andreaslagler/giove8k/README.md

# giove8k
Giove 8k audio synthesizer project
