andreaslagler/giove8k/hw/AudioBoard/AudioBoard.kicad_pcb

## KiCad design hw/AudioBoard/AudioBoard.kicad_pcb (2022-02-02)

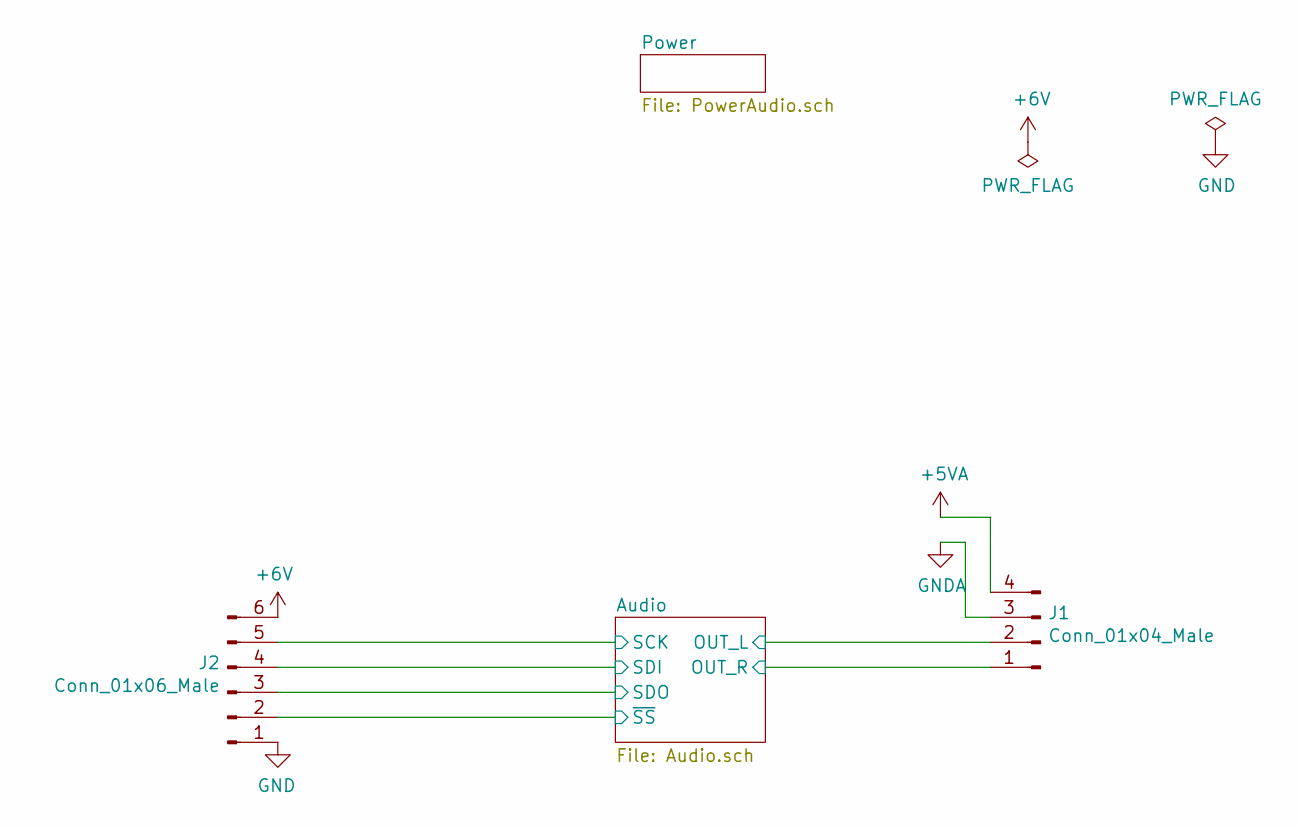
[picture p1: schematic AudioBoard.sch, Synth]

Parts:
J1: Conn_01x04_Male; PinHeader_1x04_P2.54mm_Vertical
J2: Conn_01x06_Male; PinHeader_1x06_P2.54mm_Vertical

Connections:
+5VA: J1.4; also elsewhere on the board
+6V: J2.6; also elsewhere on the board
/Audio/OUT_L: J1.2; also elsewhere on the board
/Audio/OUT_R: J1.1; also elsewhere on the board
/Audio/SCK: J2.5; also elsewhere on the board
/Audio/SDI: J2.4; also elsewhere on the board
/Audio/SDO: J2.3; also elsewhere on the board
/Audio/~SS: J2.2; also elsewhere on the board
GND: J1.3, J2.1; also elsewhere on the board

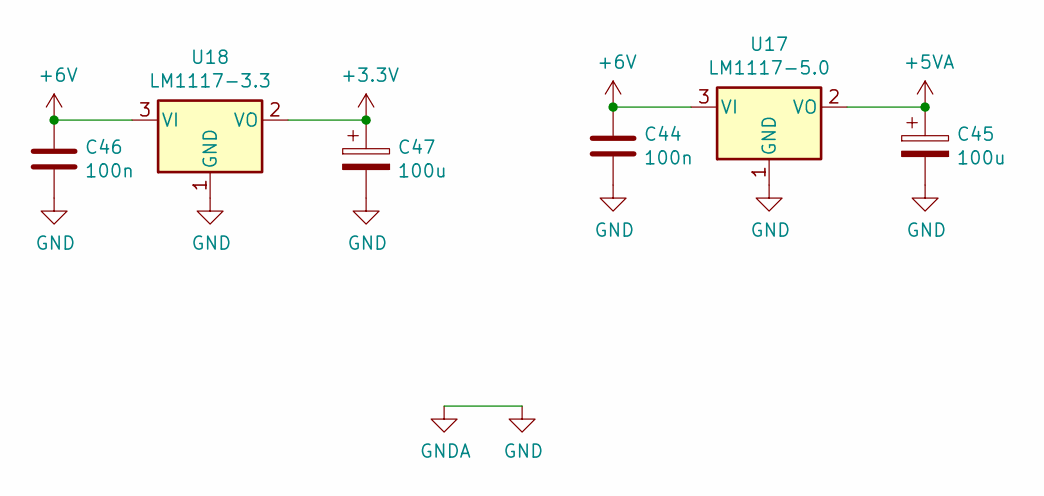
[picture p2: schematic PowerAudio.sch, Power (Controller)]

Parts:
C44, C46: 100n; C_Disc_D4.3mm_W1.9mm_P5.00mm
C45, C47: 100u; CP_Radial_D8.0mm_P5.00mm
U17: LM1117-5.0; TO-220F-3_Horizontal_TabDown
U18: LM1117-3.3; TO-220F-3_Horizontal_TabDown

Connections:
+3V3: C47.1, U18.2 (VO); also elsewhere on the board
+5VA: C45.1, U17.2 (VO); also elsewhere on the board
+6V: C44.1, C46.1, U17.3 (VI), U18.3 (VI); also elsewhere on the board
GND: C44.2, C45.2, C46.2, C47.2, U17.1 (GND), U18.1 (GND); also elsewhere on the board

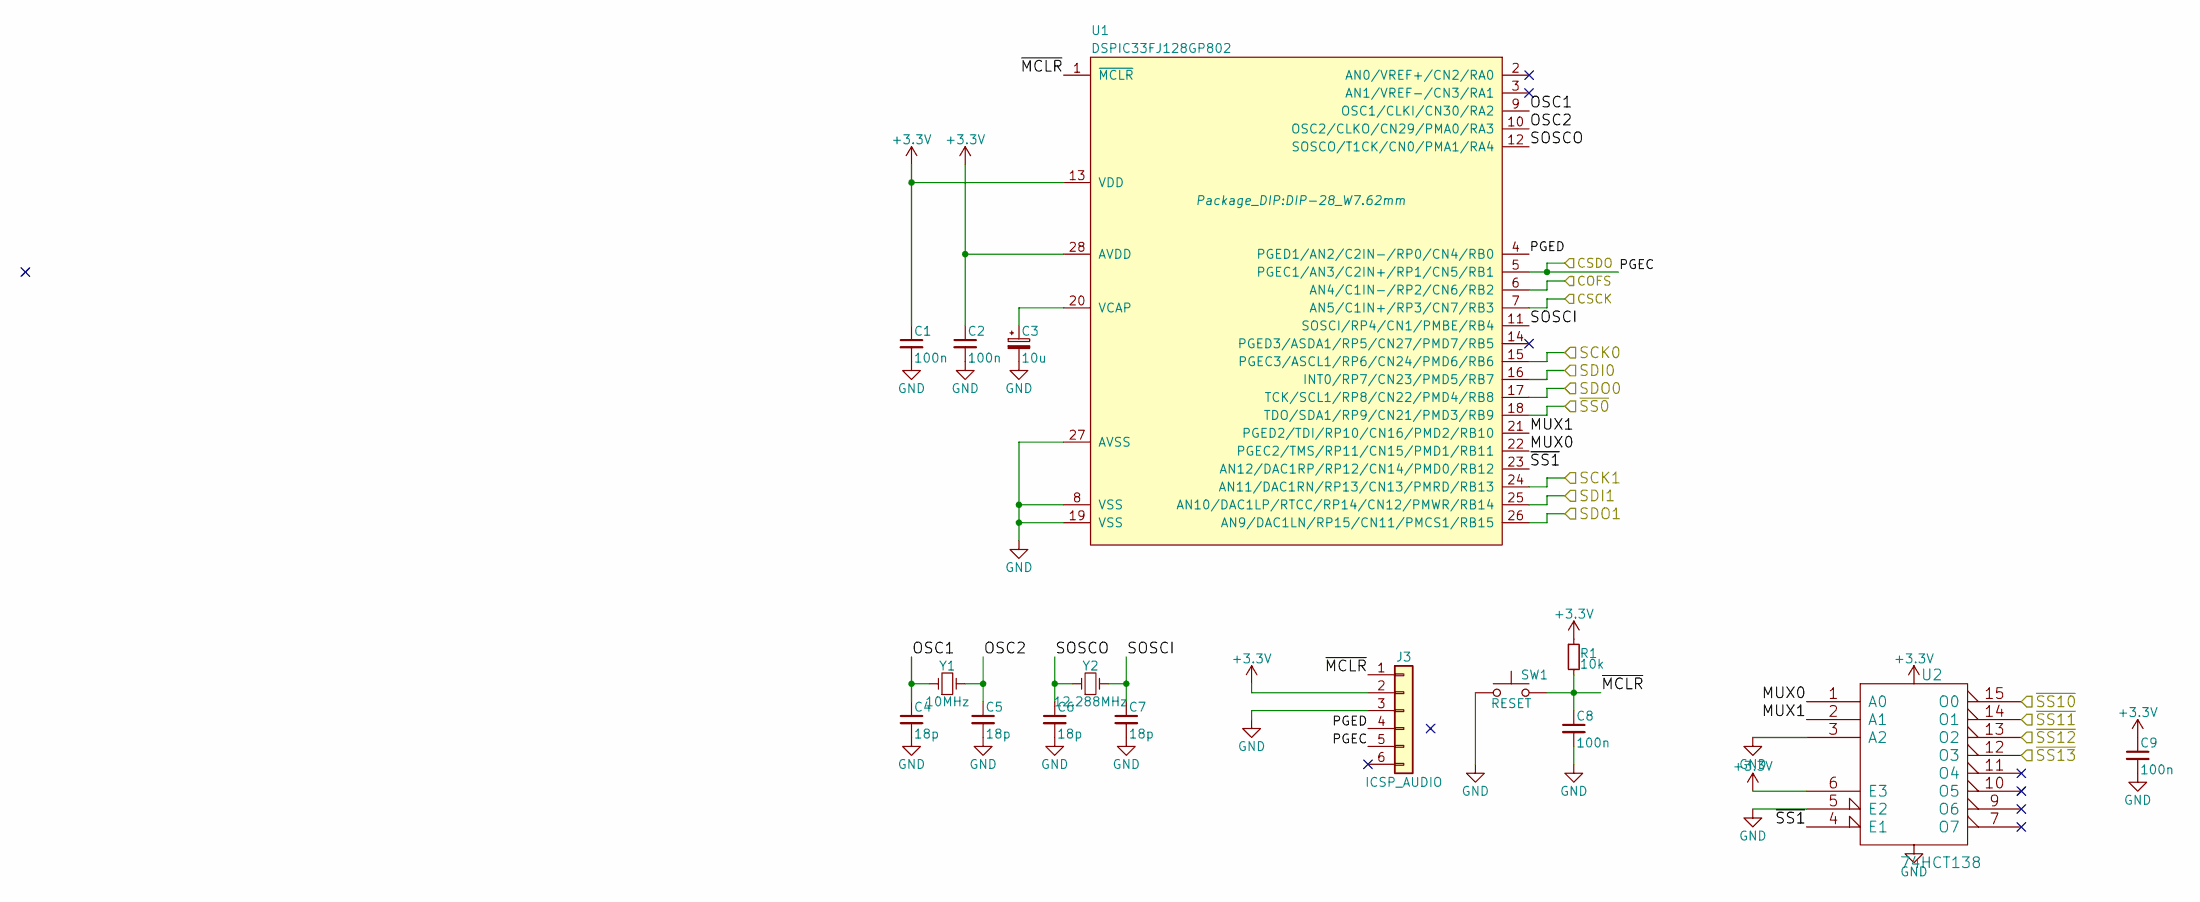
[picture p3: schematic DSP0.sch, Audio DSP]

Parts:
C1, C2, C8, C9: 100n; C_Disc_D4.3mm_W1.9mm_P5.00mm
C3: 10u; CP_Radial_D5.0mm_P2.50mm
C4, C5, C6, C7: 18p; C_Disc_D3.0mm_W1.6mm_P2.50mm
J3: ICSP_AUDIO; Molex_KK-254_AE-6410-06A_1x06_P2.54mm_Vertical
R1: 10k; R_Axial_DIN0207_L6.3mm_D2.5mm_P10.16mm_Horizontal
SW1: RESET; SW_PUSH_6mm
U1: DSPIC33FJ128GP802; DIP-28_W7.62mm
U2: 74HCT138; DIP-16_W7.62mm
Y1: 10MHz; Crystal_HC49-U_Vertical
Y2: 12.288MHz; Crystal_HC49-U_Vertical

Connections:
+3V3: C1.1, C2.1, C9.1, J3.2, R1.1, U1.13 (VDD), U1.28 (AVDD), U2.6 (E3), U2.16 (VCC); also elsewhere on the board
/Audio/COFS: U1.6 (AN4/C1IN-/RP2/CN6/RB2); also elsewhere on the board
/Audio/CSDO: J3.5, U1.5 (PGEC1/AN3/C2IN+/RP1/CN5/RB1); also elsewhere on the board
/Audio/CSK: U1.7 (AN5/C1IN+/RP3/CN7/RB3); also elsewhere on the board
/Audio/DSP0/MUX0: U1.22 (PGEC2/TMS/RP11/CN15/PMD1/RB11), U2.1 (A0)
/Audio/DSP0/MUX1: U1.21 (PGED2/TDI/RP10/CN16/PMD2/RB10), U2.2 (A1)
/Audio/DSP0/OSC1: C4.1, U1.9 (OSC1/CLKI/CN30/RA2), Y1.1
/Audio/DSP0/OSC2: C5.1, U1.10 (OSC2/CLKO/CN29/PMA0/RA3), Y1.2
/Audio/DSP0/PGED: J3.4, U1.4 (PGED1/AN2/C2IN-/RP0/CN4/RB0)
/Audio/DSP0/SOSCI: C7.1, U1.11 (SOSCI/RP4/CN1/PMBE/RB4), Y2.2
/Audio/DSP0/SOSCO: C6.1, U1.12 (SOSCO/T1CK/CN0/PMA1/RA4), Y2.1
/Audio/DSP0/~MCLR: C8.1, J3.1, R1.2, SW1.2, U1.1 (~MCLR)
/Audio/DSP0/~SS1: U1.23 (AN12/DAC1RP/RP12/CN14/PMD0/RB12), U2.4 (E1)
/Audio/SCK: U1.15 (PGEC3/ASCL1/RP6/CN24/PMD6/RB6); also elsewhere on the board
/Audio/SCK1: U1.24 (AN11/DAC1RN/RP13/CN13/PMRD/RB13); also elsewhere on the board
/Audio/SDI: U1.16 (INT0/RP7/CN23/PMD5/RB7); also elsewhere on the board
/Audio/SDI1: U1.25 (AN10/DAC1LP/RTCC/RP14/CN12/PMWR/RB14); also elsewhere on the board
/Audio/SDO: U1.17 (TCK/SCL1/RP8/CN22/PMD4/RB8); also elsewhere on the board
/Audio/SDO1: U1.26 (AN9/DAC1LN/RP15/CN11/PMCS1/RB15); also elsewhere on the board
/Audio/~SS: U1.18 (TDO/SDA1/RP9/CN21/PMD3/RB9); also elsewhere on the board
/Audio/~SS0: U2.15 (O0); also elsewhere on the board
/Audio/~SS1: U2.14 (O1); also elsewhere on the board
/Audio/~SS2: U2.13 (O2); also elsewhere on the board
/Audio/~SS3: U2.12 (O3); also elsewhere on the board
GND: C1.2, C2.2, C3.2, C4.2, C5.2, C6.2, C7.2, C8.2, C9.2, J3.3, SW1.1, U1.8 (VSS), U1.19 (VSS), U1.27 (AVSS), U2.3 (A2), U2.5 (E2), U2.8 (GND); also elsewhere on the board
unnamed: C3.1, U1.20 (VCAP)

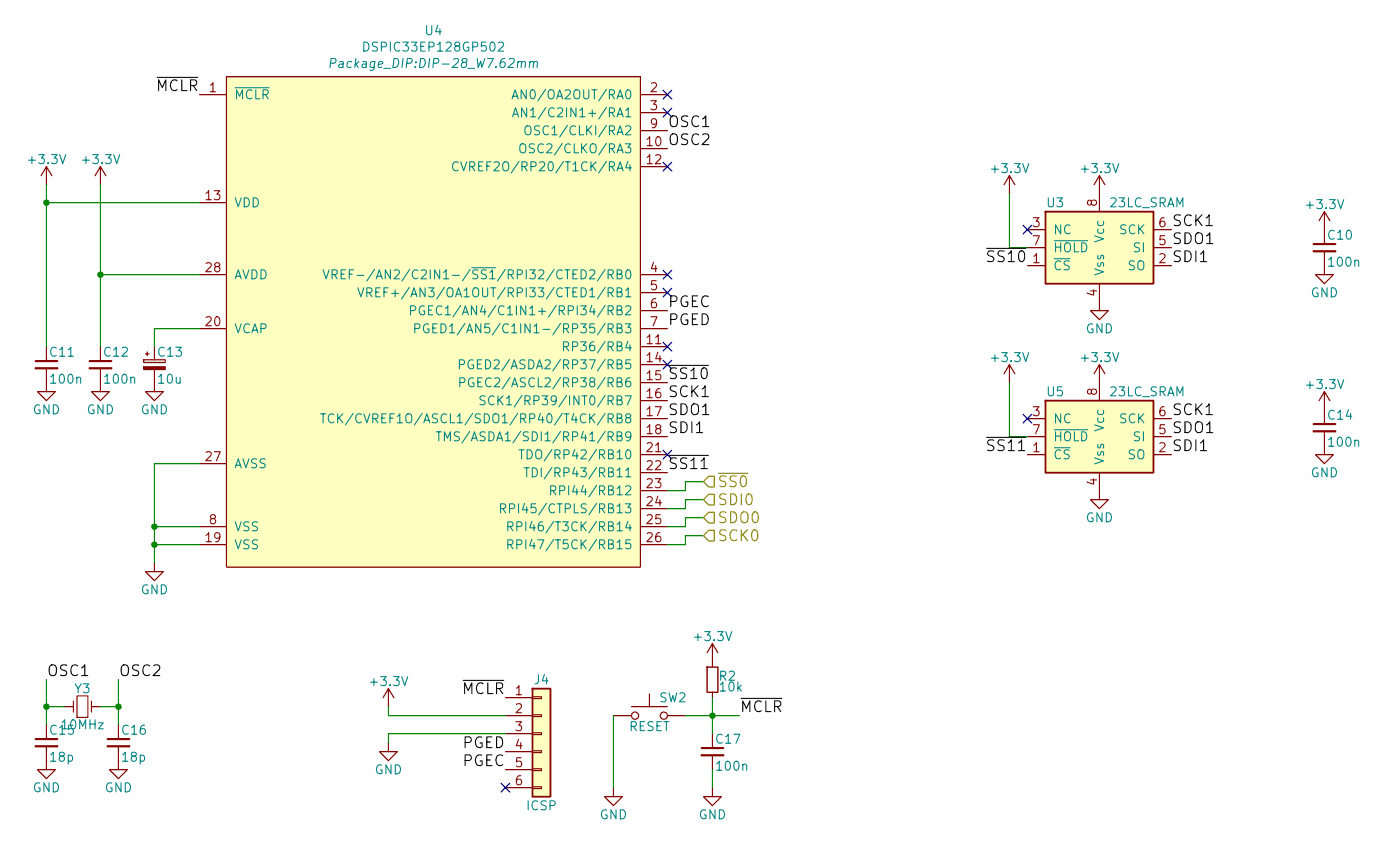
[picture p4: schematic DSP1.sch, DSP]

Parts:
C10, C11, C12, C14, C17: 100n; C_Disc_D4.3mm_W1.9mm_P5.00mm
C13: 10u; CP_Radial_D5.0mm_P2.50mm
C15, C16: 18p; C_Disc_D3.0mm_W1.6mm_P2.50mm
J4: ICSP; Molex_KK-254_AE-6410-06A_1x06_P2.54mm_Vertical
R2: 10k; R_Axial_DIN0207_L6.3mm_D2.5mm_P10.16mm_Horizontal
SW2: RESET; SW_PUSH_6mm
U3, U5: 23LC_SRAM; DIP-8_W7.62mm
U4: DSPIC33EP128GP502; DIP-28_W7.62mm
Y3: 10MHz; Crystal_HC49-U_Vertical

Connections:
+3V3: C10.1, C11.1, C12.1, C14.1, J4.2, R2.1, U3.7 (~HOLD), U3.8 (Vcc), U4.13 (VDD), U4.28 (AVDD), U5.7 (~HOLD), U5.8 (Vcc); also elsewhere on the board
/Audio/DSP1/OSC1: C15.1, U4.9 (OSC1/CLKI/RA2), Y3.1
/Audio/DSP1/OSC2: C16.1, U4.10 (OSC2/CLKO/RA3), Y3.2
/Audio/DSP1/PGEC: J4.5, U4.6 (PGEC1/AN4/C1IN1+/RPI34/RB2)
/Audio/DSP1/PGED: J4.4, U4.7 (PGED1/AN5/C1IN1-/RP35/RB3)
/Audio/DSP1/SCK1: U3.6 (SCK), U4.16 (SCK1/RP39/INT0/RB7), U5.6 (SCK)
/Audio/DSP1/SDI1: U3.2 (SO), U4.18 (TMS/ASDA1/SDI1/RP41/RB9), U5.2 (SO)
/Audio/DSP1/SDO1: U3.5 (SI), U4.17 (TCK/CVREF1O/ASCL1/SDO1/RP40/T4CK/RB8), U5.5 (SI)
/Audio/DSP1/~MCLR: C17.1, J4.1, R2.2, SW2.2, U4.1 (~MCLR)
/Audio/DSP1/~SS10: U3.1 (~CS), U4.15 (PGEC2/ASCL2/RP38/RB6)
/Audio/DSP1/~SS11: U4.22 (TDI/RP43/RB11), U5.1 (~CS)
/Audio/SCK1: U4.26 (RPI47/T5CK/RB15); also elsewhere on the board
/Audio/SDI1: U4.25 (RPI46/T3CK/RB14); also elsewhere on the board
/Audio/SDO1: U4.24 (RPI45/CTPLS/RB13); also elsewhere on the board
/Audio/~SS0: U4.23 (RPI44/RB12); also elsewhere on the board
GND: C10.2, C11.2, C12.2, C13.2, C14.2, C15.2, C16.2, C17.2, J4.3, SW2.1, U3.4 (Vss), U4.8 (VSS), U4.19 (VSS), U4.27 (AVSS), U5.4 (Vss); also elsewhere on the board
unnamed: C13.1, U4.20 (VCAP)

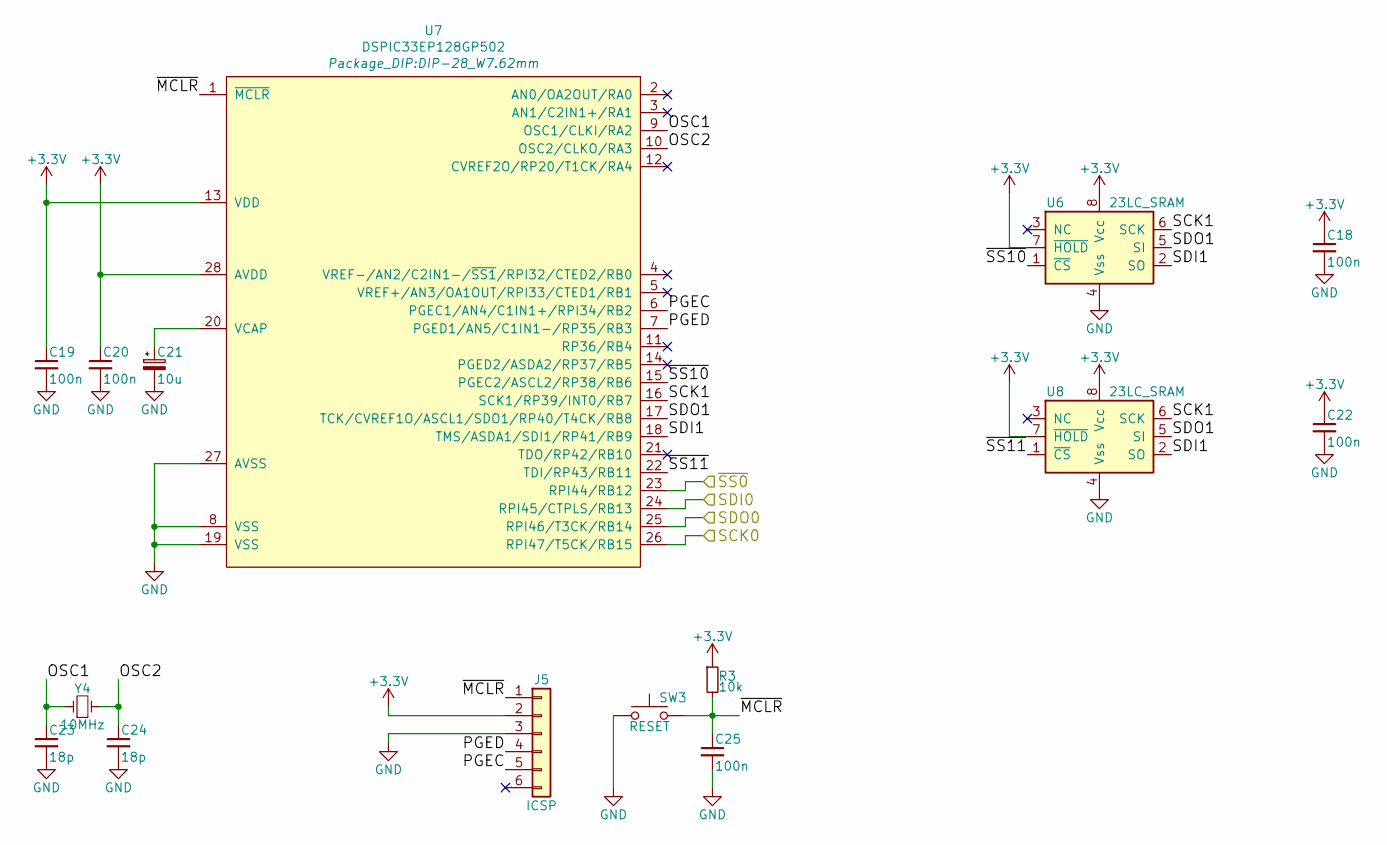
[picture p5: schematic DSP4.sch, DSP]

Parts:
C18, C19, C20, C22, C25: 100n; C_Disc_D4.3mm_W1.9mm_P5.00mm
C21: 10u; CP_Radial_D5.0mm_P2.50mm
C23, C24: 18p; C_Disc_D3.0mm_W1.6mm_P2.50mm
J5: ICSP; Molex_KK-254_AE-6410-06A_1x06_P2.54mm_Vertical
R3: 10k; R_Axial_DIN0207_L6.3mm_D2.5mm_P10.16mm_Horizontal
SW3: RESET; SW_PUSH_6mm
U6, U8: 23LC_SRAM; DIP-8_W7.62mm
U7: DSPIC33EP128GP502; DIP-28_W7.62mm
Y4: 10MHz; Crystal_HC49-U_Vertical

Connections:
+3V3: C18.1, C19.1, C20.1, C22.1, J5.2, R3.1, U6.7 (~HOLD), U6.8 (Vcc), U7.13 (VDD), U7.28 (AVDD), U8.7 (~HOLD), U8.8 (Vcc); also elsewhere on the board
/Audio/DSP4/OSC1: C23.1, U7.9 (OSC1/CLKI/RA2), Y4.1
/Audio/DSP4/OSC2: C24.1, U7.10 (OSC2/CLKO/RA3), Y4.2
/Audio/DSP4/PGEC: J5.5, U7.6 (PGEC1/AN4/C1IN1+/RPI34/RB2)
/Audio/DSP4/PGED: J5.4, U7.7 (PGED1/AN5/C1IN1-/RP35/RB3)
/Audio/DSP4/SCK1: U6.6 (SCK), U7.16 (SCK1/RP39/INT0/RB7), U8.6 (SCK)
/Audio/DSP4/SDI1: U6.2 (SO), U7.18 (TMS/ASDA1/SDI1/RP41/RB9), U8.2 (SO)
/Audio/DSP4/SDO1: U6.5 (SI), U7.17 (TCK/CVREF1O/ASCL1/SDO1/RP40/T4CK/RB8), U8.5 (SI)
/Audio/DSP4/~MCLR: C25.1, J5.1, R3.2, SW3.2, U7.1 (~MCLR)
/Audio/DSP4/~SS10: U6.1 (~CS), U7.15 (PGEC2/ASCL2/RP38/RB6)
/Audio/DSP4/~SS11: U7.22 (TDI/RP43/RB11), U8.1 (~CS)
/Audio/SCK1: U7.26 (RPI47/T5CK/RB15); also elsewhere on the board
/Audio/SDI1: U7.25 (RPI46/T3CK/RB14); also elsewhere on the board
/Audio/SDO1: U7.24 (RPI45/CTPLS/RB13); also elsewhere on the board
/Audio/~SS3: U7.23 (RPI44/RB12); also elsewhere on the board
GND: C18.2, C19.2, C20.2, C21.2, C22.2, C23.2, C24.2, C25.2, J5.3, SW3.1, U6.4 (Vss), U7.8 (VSS), U7.19 (VSS), U7.27 (AVSS), U8.4 (Vss); also elsewhere on the board
unnamed: C21.1, U7.20 (VCAP)

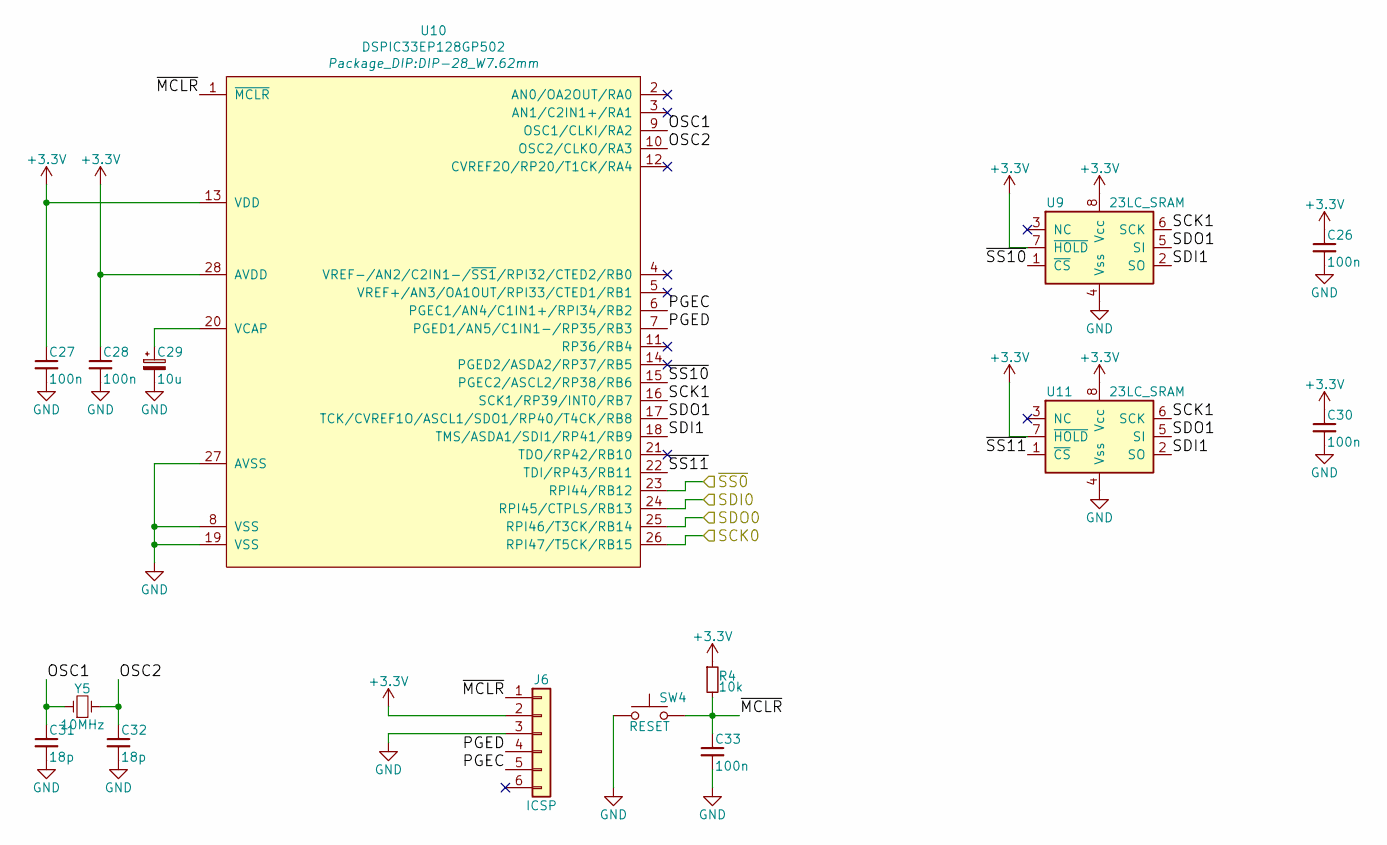
[picture p6: schematic DSP3.sch, DSP]

Parts:
C26, C27, C28, C30, C33: 100n; C_Disc_D4.3mm_W1.9mm_P5.00mm
C29: 10u; CP_Radial_D5.0mm_P2.50mm
C31, C32: 18p; C_Disc_D3.0mm_W1.6mm_P2.50mm
J6: ICSP; Molex_KK-254_AE-6410-06A_1x06_P2.54mm_Vertical
R4: 10k; R_Axial_DIN0207_L6.3mm_D2.5mm_P10.16mm_Horizontal
SW4: RESET; SW_PUSH_6mm
U9, U11: 23LC_SRAM; DIP-8_W7.62mm
U10: DSPIC33EP128GP502; DIP-28_W7.62mm
Y5: 10MHz; Crystal_HC49-U_Vertical

Connections:
+3V3: C26.1, C27.1, C28.1, C30.1, J6.2, R4.1, U9.7 (~HOLD), U9.8 (Vcc), U10.13 (VDD), U10.28 (AVDD), U11.7 (~HOLD), U11.8 (Vcc); also elsewhere on the board
/Audio/DSP3/OSC1: C31.1, U10.9 (OSC1/CLKI/RA2), Y5.1
/Audio/DSP3/OSC2: C32.1, U10.10 (OSC2/CLKO/RA3), Y5.2
/Audio/DSP3/PGEC: J6.5, U10.6 (PGEC1/AN4/C1IN1+/RPI34/RB2)
/Audio/DSP3/PGED: J6.4, U10.7 (PGED1/AN5/C1IN1-/RP35/RB3)
/Audio/DSP3/SCK1: U9.6 (SCK), U10.16 (SCK1/RP39/INT0/RB7), U11.6 (SCK)
/Audio/DSP3/SDI1: U9.2 (SO), U10.18 (TMS/ASDA1/SDI1/RP41/RB9), U11.2 (SO)
/Audio/DSP3/SDO1: U9.5 (SI), U10.17 (TCK/CVREF1O/ASCL1/SDO1/RP40/T4CK/RB8), U11.5 (SI)
/Audio/DSP3/~MCLR: C33.1, J6.1, R4.2, SW4.2, U10.1 (~MCLR)
/Audio/DSP3/~SS10: U9.1 (~CS), U10.15 (PGEC2/ASCL2/RP38/RB6)
/Audio/DSP3/~SS11: U10.22 (TDI/RP43/RB11), U11.1 (~CS)
/Audio/SCK1: U10.26 (RPI47/T5CK/RB15); also elsewhere on the board
/Audio/SDI1: U10.25 (RPI46/T3CK/RB14); also elsewhere on the board
/Audio/SDO1: U10.24 (RPI45/CTPLS/RB13); also elsewhere on the board
/Audio/~SS2: U10.23 (RPI44/RB12); also elsewhere on the board
GND: C26.2, C27.2, C28.2, C29.2, C30.2, C31.2, C32.2, C33.2, J6.3, SW4.1, U9.4 (Vss), U10.8 (VSS), U10.19 (VSS), U10.27 (AVSS), U11.4 (Vss); also elsewhere on the board
unnamed: C29.1, U10.20 (VCAP)

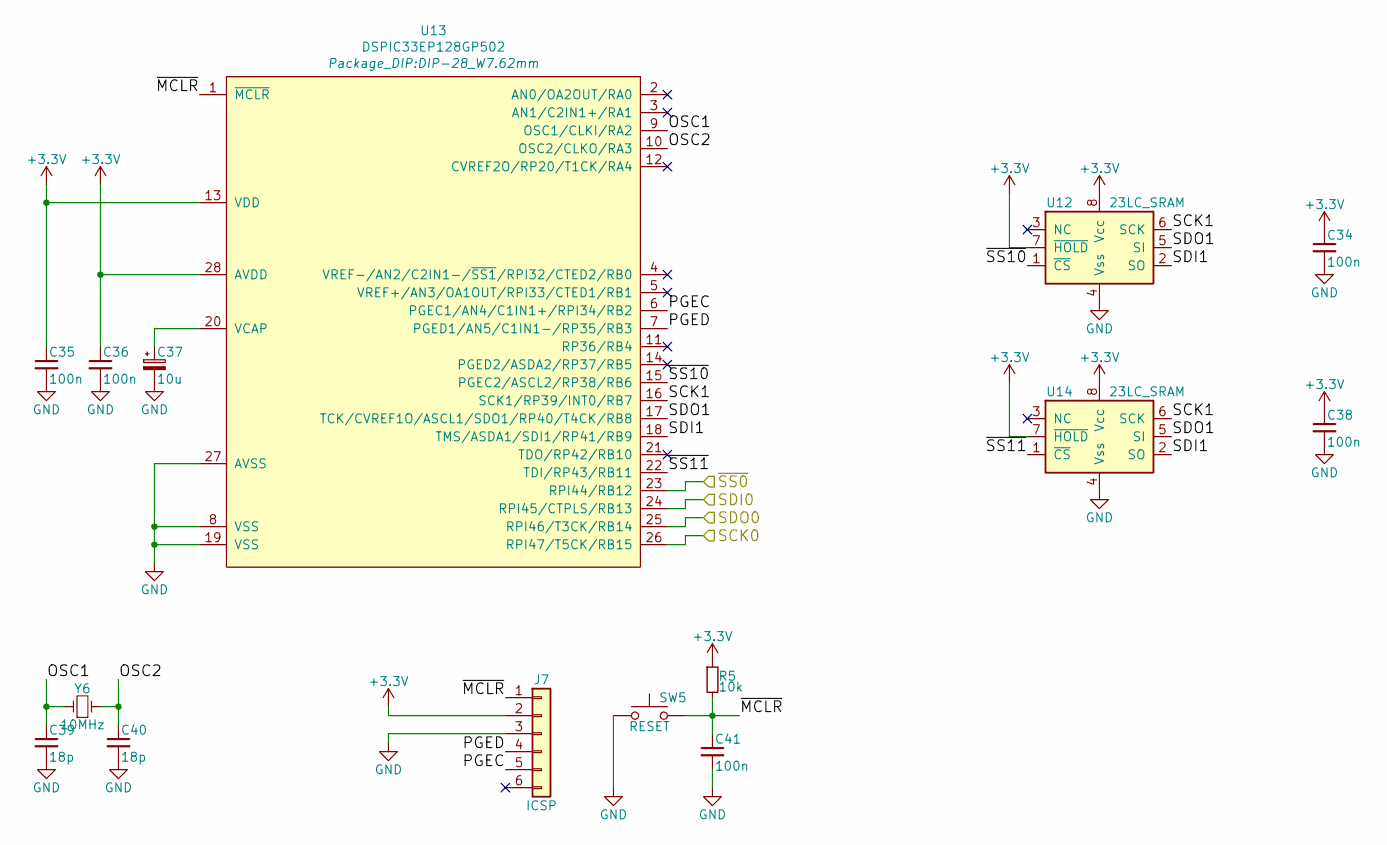
[picture p7: schematic DSP2.sch, DSP]

Parts:
C34, C35, C36, C38, C41: 100n; C_Disc_D4.3mm_W1.9mm_P5.00mm
C37: 10u; CP_Radial_D5.0mm_P2.50mm
C39, C40: 18p; C_Disc_D3.0mm_W1.6mm_P2.50mm
J7: ICSP; Molex_KK-254_AE-6410-06A_1x06_P2.54mm_Vertical
R5: 10k; R_Axial_DIN0207_L6.3mm_D2.5mm_P10.16mm_Horizontal
SW5: RESET; SW_PUSH_6mm
U12, U14: 23LC_SRAM; DIP-8_W7.62mm
U13: DSPIC33EP128GP502; DIP-28_W7.62mm
Y6: 10MHz; Crystal_HC49-U_Vertical

Connections:
+3V3: C34.1, C35.1, C36.1, C38.1, J7.2, R5.1, U12.7 (~HOLD), U12.8 (Vcc), U13.13 (VDD), U13.28 (AVDD), U14.7 (~HOLD), U14.8 (Vcc); also elsewhere on the board
/Audio/DSP2/OSC1: C39.1, U13.9 (OSC1/CLKI/RA2), Y6.1
/Audio/DSP2/OSC2: C40.1, U13.10 (OSC2/CLKO/RA3), Y6.2
/Audio/DSP2/PGEC: J7.5, U13.6 (PGEC1/AN4/C1IN1+/RPI34/RB2)
/Audio/DSP2/PGED: J7.4, U13.7 (PGED1/AN5/C1IN1-/RP35/RB3)
/Audio/DSP2/SCK1: U12.6 (SCK), U13.16 (SCK1/RP39/INT0/RB7), U14.6 (SCK)
/Audio/DSP2/SDI1: U12.2 (SO), U13.18 (TMS/ASDA1/SDI1/RP41/RB9), U14.2 (SO)
/Audio/DSP2/SDO1: U12.5 (SI), U13.17 (TCK/CVREF1O/ASCL1/SDO1/RP40/T4CK/RB8), U14.5 (SI)
/Audio/DSP2/~MCLR: C41.1, J7.1, R5.2, SW5.2, U13.1 (~MCLR)
/Audio/DSP2/~SS10: U12.1 (~CS), U13.15 (PGEC2/ASCL2/RP38/RB6)
/Audio/DSP2/~SS11: U13.22 (TDI/RP43/RB11), U14.1 (~CS)
/Audio/SCK1: U13.26 (RPI47/T5CK/RB15); also elsewhere on the board
/Audio/SDI1: U13.25 (RPI46/T3CK/RB14); also elsewhere on the board
/Audio/SDO1: U13.24 (RPI45/CTPLS/RB13); also elsewhere on the board
/Audio/~SS1: U13.23 (RPI44/RB12); also elsewhere on the board
GND: C34.2, C35.2, C36.2, C37.2, C38.2, C39.2, C40.2, C41.2, J7.3, SW5.1, U12.4 (Vss), U13.8 (VSS), U13.19 (VSS), U13.27 (AVSS), U14.4 (Vss); also elsewhere on the board
unnamed: C37.1, U13.20 (VCAP)

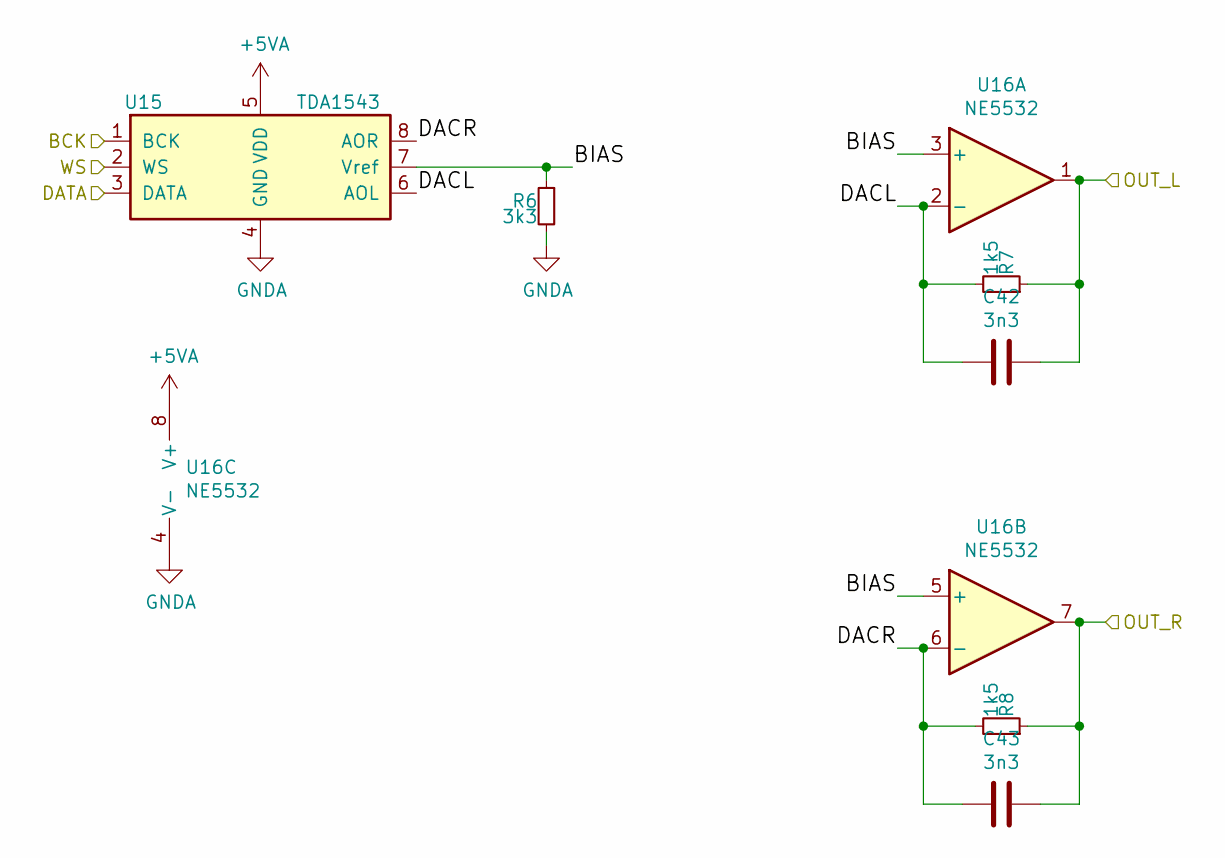
[picture p8: schematic DAC.sch]

Parts:
C42, C43: 3n3; C_Disc_D4.3mm_W1.9mm_P5.00mm
R6: 3k3; R_Axial_DIN0207_L6.3mm_D2.5mm_P10.16mm_Horizontal
R7, R8: 1k5; R_Axial_DIN0207_L6.3mm_D2.5mm_P10.16mm_Horizontal
U15: TDA1543; DIP-8_W7.62mm
U16: NE5532; DIP-8_W7.62mm

Connections:
+5VA: U15.5 (VDD), U16.8 (V+); also elsewhere on the board
/Audio/COFS: U15.2 (WS); also elsewhere on the board
/Audio/CSDO: U15.3 (DATA); also elsewhere on the board
/Audio/CSK: U15.1 (BCK); also elsewhere on the board
/Audio/DAC/BIAS: R6.1, U15.7 (Vref), U16.3 (+), U16.5 (+)
/Audio/DAC/DACL: C42.2, R7.2, U15.6 (AOL), U16.2 (-)
/Audio/DAC/DACR: C43.2, R8.2, U15.8 (AOR), U16.6 (-)
/Audio/OUT_L: C42.1, R7.1, U16.1; also elsewhere on the board
/Audio/OUT_R: C43.1, R8.1, U16.7; also elsewhere on the board
GND: R6.2, U15.4 (GND), U16.4 (V-); also elsewhere on the board

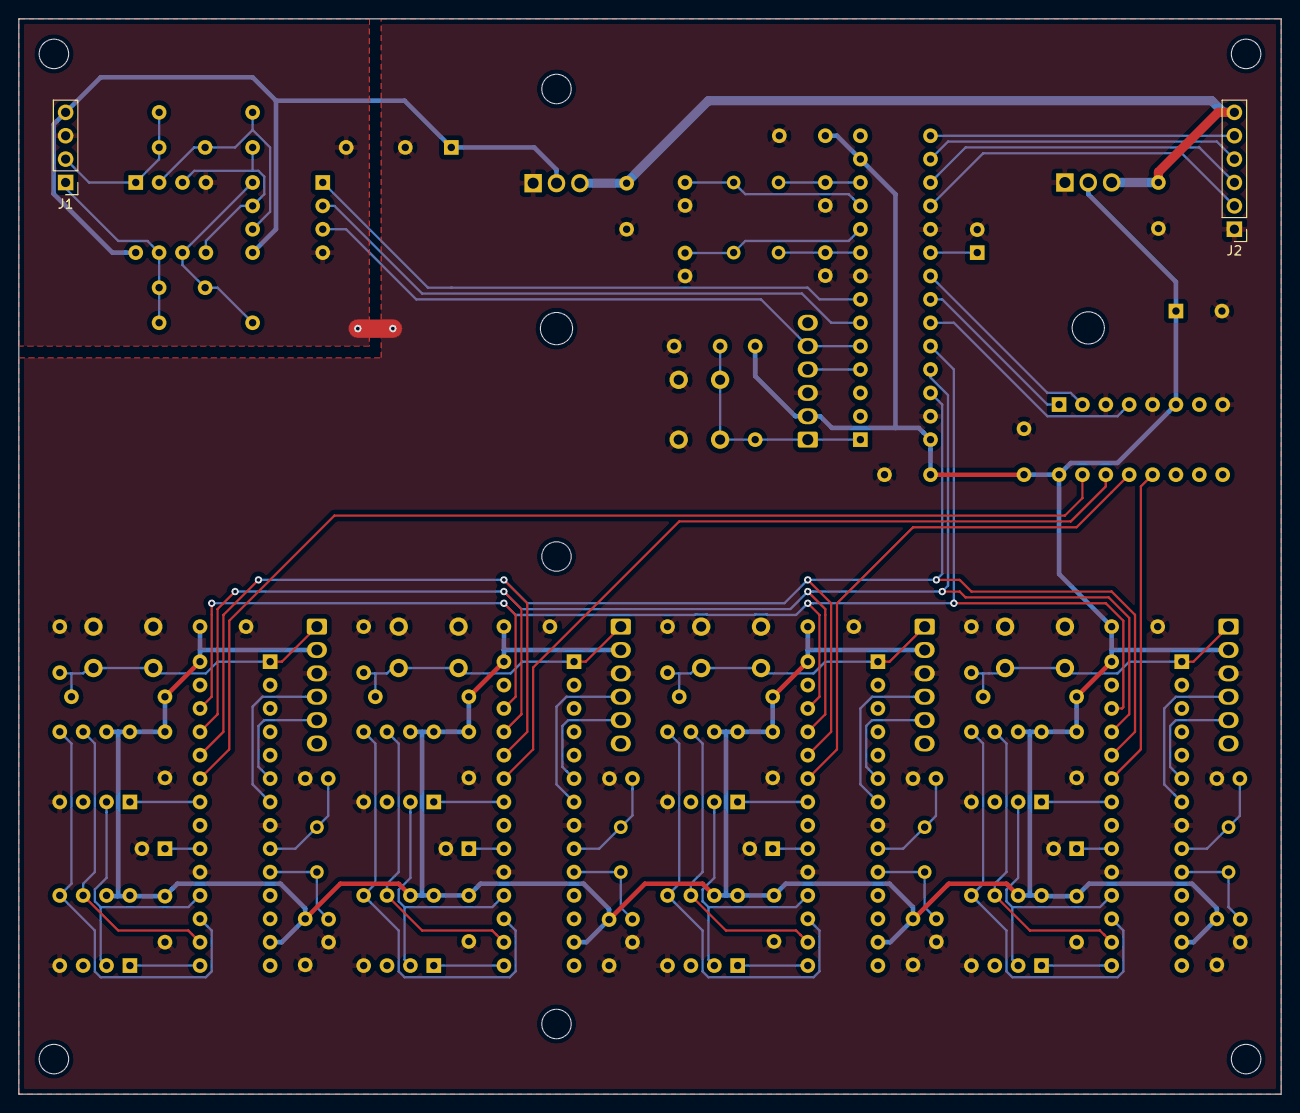
[picture p9: board AudioBoard.kicad_pcb from above]

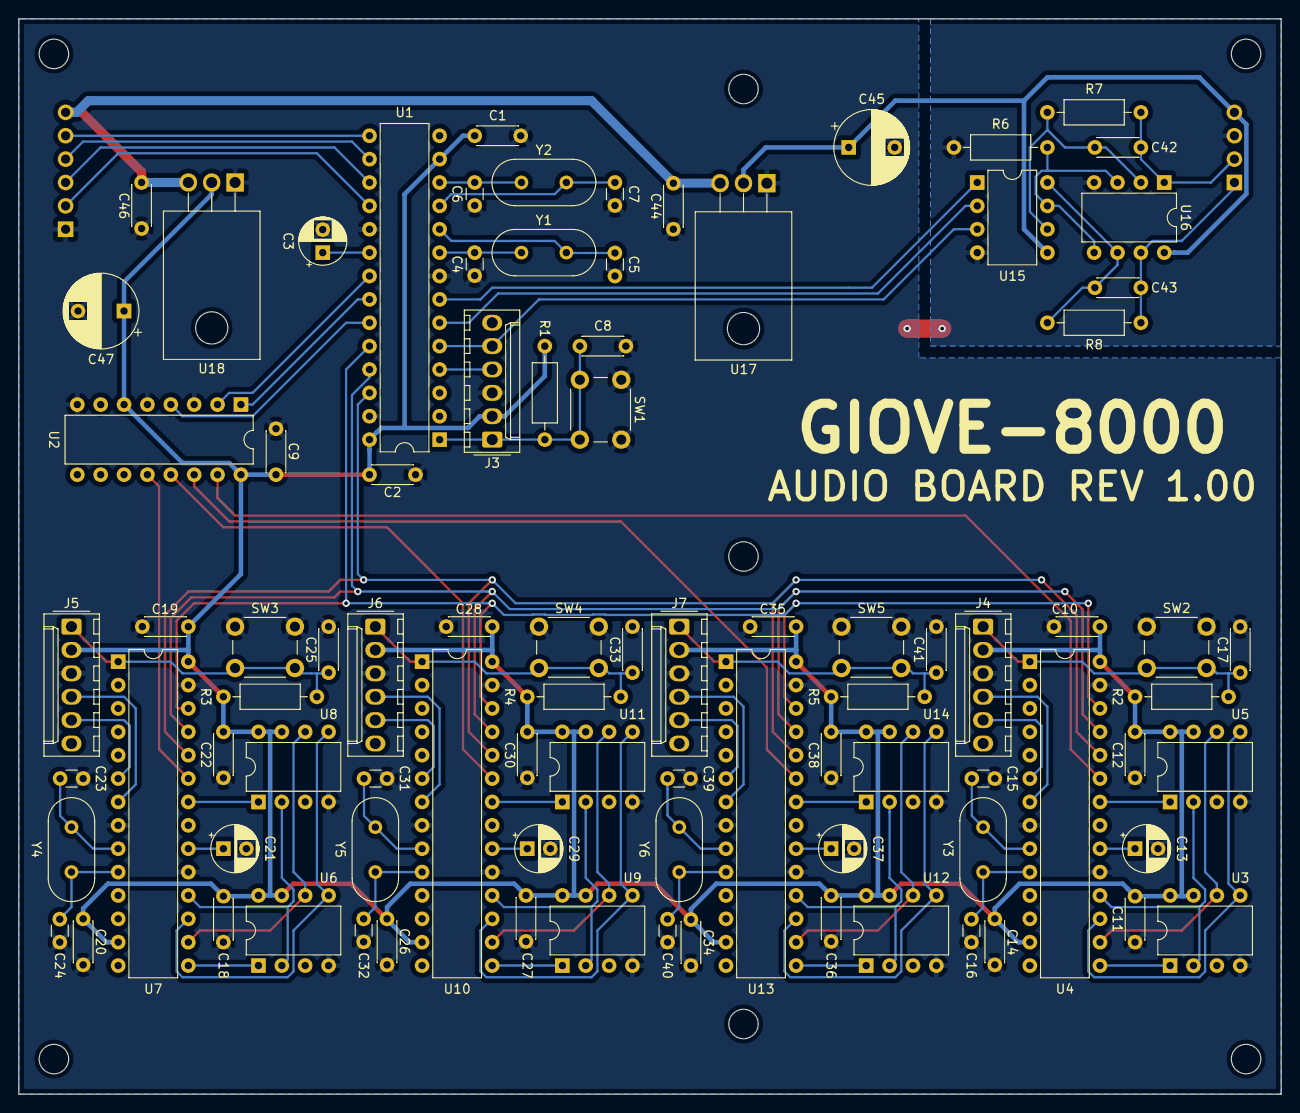
[picture p10: board AudioBoard.kicad_pcb from below]

Board: 2 copper layers, 137.2 x 116.8 mm, 91 parts (89 on the bottom side), 77 nets.
