andreaslagler/giove8k/hw/ControlBoard/ControlBoard.kicad_pcb

## KiCad design hw/ControlBoard/ControlBoard.kicad_pcb (2022-02-02)

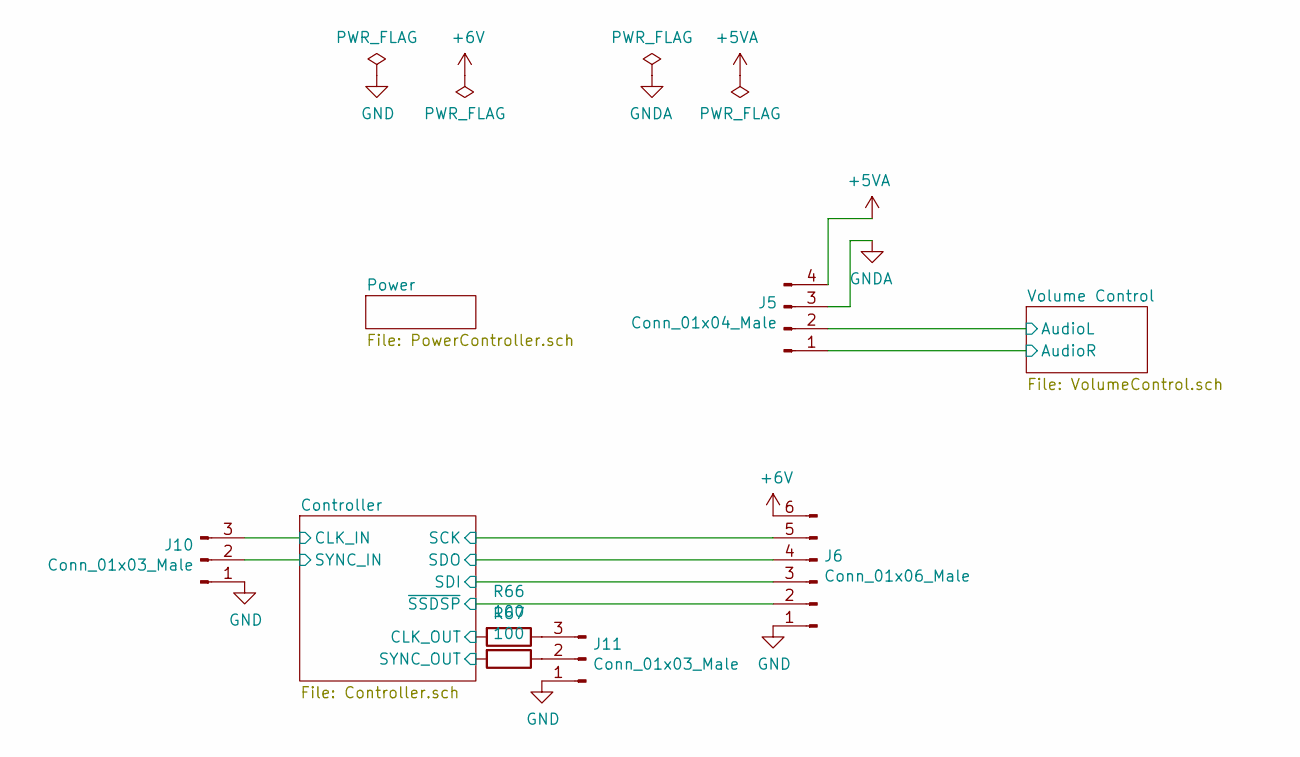
[picture p11: schematic ControlBoard.sch, Synth]

Parts:
J5: Conn_01x04_Male; PinHeader_1x04_P2.54mm_Vertical
J6: Conn_01x06_Male; PinHeader_1x06_P2.54mm_Vertical
J10, J11: Conn_01x03_Male; Molex_KK-254_AE-6410-03A_1x03_P2.54mm_Vertical
R66, R67: 100; R_Axial_DIN0207_L6.3mm_D2.5mm_P10.16mm_Horizontal

Connections:
+5VA: J5.4; also elsewhere on the board
+6V: J6.6; also elsewhere on the board
/Controller/CLK_IN: J10.3; also elsewhere on the board
/Controller/CLK_OUT: R66.2; also elsewhere on the board
/Controller/SCK: J6.5; also elsewhere on the board
/Controller/SDI: J6.3; also elsewhere on the board
/Controller/SDO: J6.4; also elsewhere on the board
/Controller/SYNC_IN: J10.2; also elsewhere on the board
/Controller/SYNC_OUT: R67.2; also elsewhere on the board
/Controller/~SSDSP: J6.2; also elsewhere on the board
/Volume Control/AudioL: J5.2; also elsewhere on the board
/Volume Control/AudioR: J5.1; also elsewhere on the board
GND: J6.1, J10.1, J11.1; also elsewhere on the board
GNDA: J5.3; also elsewhere on the board
unnamed: J11.2, R67.1
unnamed: J11.3, R66.1

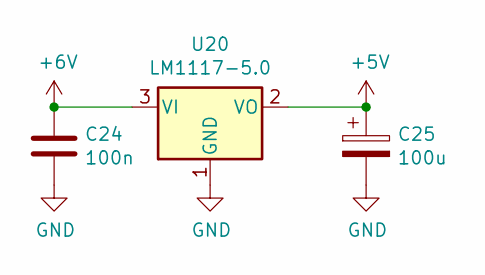
[picture p12: schematic PowerController.sch, Power (Controller)]

Parts:
C24: 100n; C_Disc_D5.0mm_W2.5mm_P5.00mm
C25: 100u; CP_Radial_D8.0mm_P5.00mm
U20: LM1117-5.0; TO-220-3_Vertical

Connections:
+5V: C25.1, U20.2 (VO); also elsewhere on the board
+6V: C24.1, U20.3 (VI); also elsewhere on the board
GND: C24.2, C25.2, U20.1 (GND); also elsewhere on the board

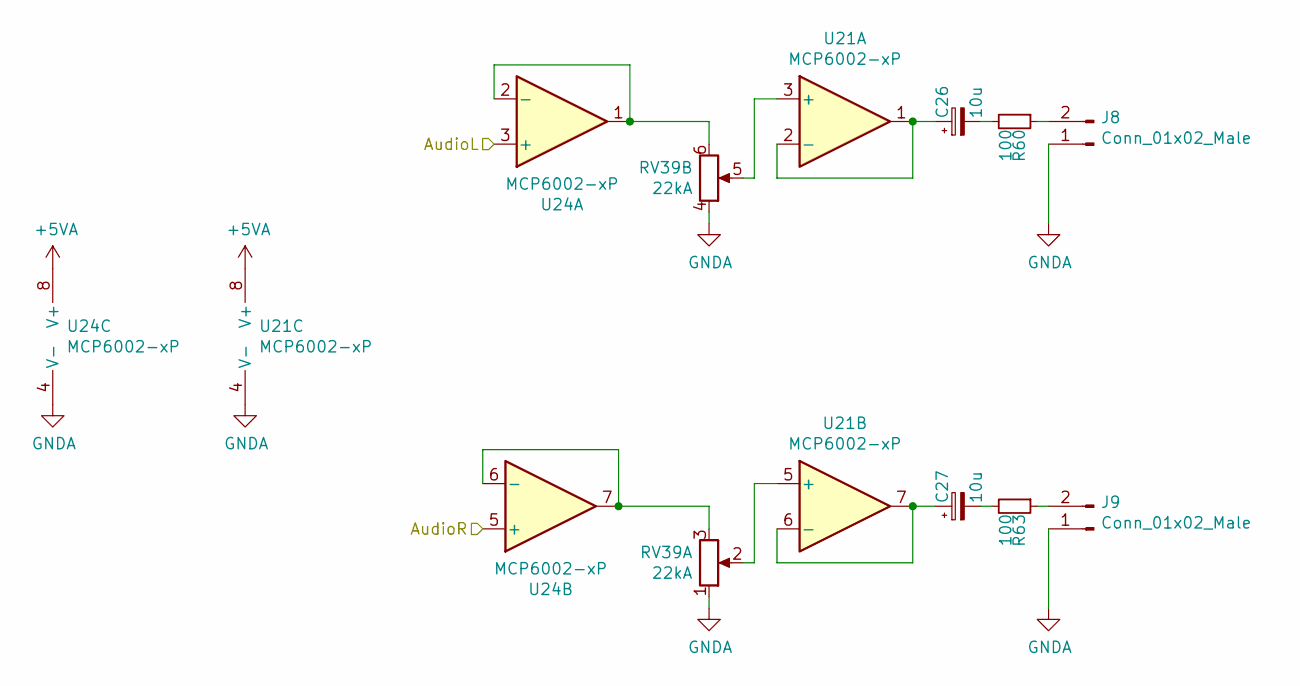
[picture p13: schematic VolumeControl.sch, Volume Control]

Parts:
C26, C27: 10u; CP_Radial_D5.0mm_P2.50mm
J8, J9: Conn_01x02_Male; Molex_KK-254_AE-6410-02A_1x02_P2.54mm_Vertical
R60, R63: 100; R_Axial_DIN0207_L6.3mm_D2.5mm_P10.16mm_Horizontal
RV39: 22kA; Potentiometer_Alpha_RD902F-40-00D_Dual_Vertical_CircularHol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
U21, U24: MCP6002-xP; DIP-8_W7.62mm

Connections:
+5VA: U21.8 (V+), U24.8 (V+); also elsewhere on the board
/Volume Control/AudioL: U24.3 (+); also elsewhere on the board
/Volume Control/AudioR: U24.5 (+); also elsewhere on the board
GNDA: J8.1, J9.1, RV39.1, RV39.4, U21.4 (V-), U24.4 (V-); also elsewhere on the board
unnamed: C26.1, U21.1, U21.2 (-)
unnamed: C26.2, R60.2
unnamed: C27.1, U21.6 (-), U21.7
unnamed: C27.2, R63.2
unnamed: J8.2, R60.1
unnamed: J9.2, R63.1
unnamed: RV39.2, U21.5 (+)
unnamed: RV39.3, U24.6 (-), U24.7
unnamed: RV39.5, U21.3 (+)
unnamed: RV39.6, U24.1, U24.2 (-)
