andreaslagler/giove8k/hw/ControlBoard/ControlBoard.kicad_pcb

## KiCad design hw/ControlBoard/ControlBoard.kicad_pcb (continued)

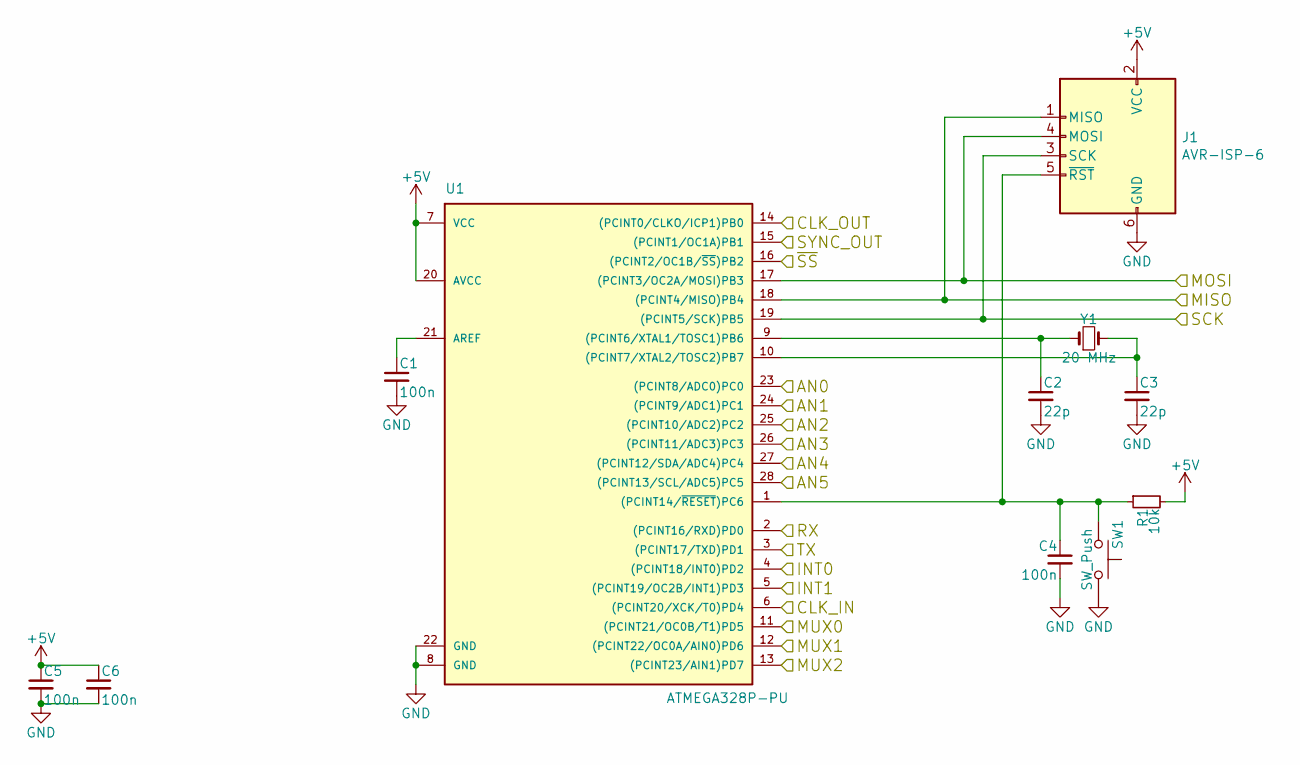
[picture p14: schematic CPU.sch, CPU m328p]

Parts:
C1, C4, C5, C6: 100n; C_Disc_D5.0mm_W2.5mm_P5.00mm
C2, C3: 22p; C_Disc_D3.0mm_W1.6mm_P2.50mm
J1: AVR-ISP-6; IDC-Header_2x03_P2.54mm_Vertical
R1: 10k; R_Axial_DIN0207_L6.3mm_D2.5mm_P10.16mm_Horizontal
SW1: SW_Push; SW_PUSH_6mm
U1: ATMEGA328P-PU; DIP-28_W7.62mm
Y1: 20 MHz; Crystal_HC49-U_Vertical

Connections:
+5V: C5.1, C6.1, J1.2 (VCC), R1.2, U1.7 (VCC), U1.20 (AVCC); also elsewhere on the board
/Controller/AN0: U1.23 ((PCINT8/ADC0)PC0); also elsewhere on the board
/Controller/AN1: U1.24 ((PCINT9/ADC1)PC1); also elsewhere on the board
/Controller/AN2: U1.25 ((PCINT10/ADC2)PC2); also elsewhere on the board
/Controller/AN3: U1.26 ((PCINT11/ADC3)PC3); also elsewhere on the board
/Controller/AN4: U1.27 ((PCINT12/SDA/ADC4)PC4); also elsewhere on the board
/Controller/CLK_IN: U1.6 ((PCINT20/XCK/T0)PD4); also elsewhere on the board
/Controller/CLK_OUT: U1.14 ((PCINT0/CLKO/ICP1)PB0); also elsewhere on the board
/Controller/INT0: U1.4 ((PCINT18/INT0)PD2); also elsewhere on the board
/Controller/INT1: U1.5 ((PCINT19/OC2B/INT1)PD3); also elsewhere on the board
/Controller/MUX0: U1.11 ((PCINT21/OC0B/T1)PD5); also elsewhere on the board
/Controller/MUX1: U1.12 ((PCINT22/OC0A/AIN0)PD6); also elsewhere on the board
/Controller/MUX2: U1.13 ((PCINT23/AIN1)PD7); also elsewhere on the board
/Controller/Rx: U1.2 ((PCINT16/RXD)PD0); also elsewhere on the board
/Controller/SCK: J1.3 (SCK), U1.19 ((PCINT5/SCK)PB5); also elsewhere on the board
/Controller/SDI: J1.1 (MISO), U1.18 ((PCINT4/MISO)PB4); also elsewhere on the board
/Controller/SDO: J1.4 (MOSI), U1.17 ((PCINT3/OC2A/MOSI)PB3); also elsewhere on the board
/Controller/SYNC_OUT: U1.15 ((PCINT1/OC1A)PB1); also elsewhere on the board
/Controller/Tx: U1.3 ((PCINT17/TXD)PD1); also elsewhere on the board
/Controller/~SS: U1.16 ((PCINT2/OC1B/~SS~)PB2); also elsewhere on the board
GND: C1.2, C2.2, C3.2, C4.2, C5.2, C6.2, J1.6 (GND), SW1.1, U1.8 (GND), U1.22 (GND); also elsewhere on the board
unnamed: C1.1, U1.21 (AREF)
unnamed: C2.1, U1.9 ((PCINT6/XTAL1/TOSC1)PB6), Y1.1
unnamed: C3.1, U1.10 ((PCINT7/XTAL2/TOSC2)PB7), Y1.2
unnamed: C4.1, J1.5 (~RST), R1.1, SW1.2, U1.1 ((PCINT14/~RESET~)PC6)

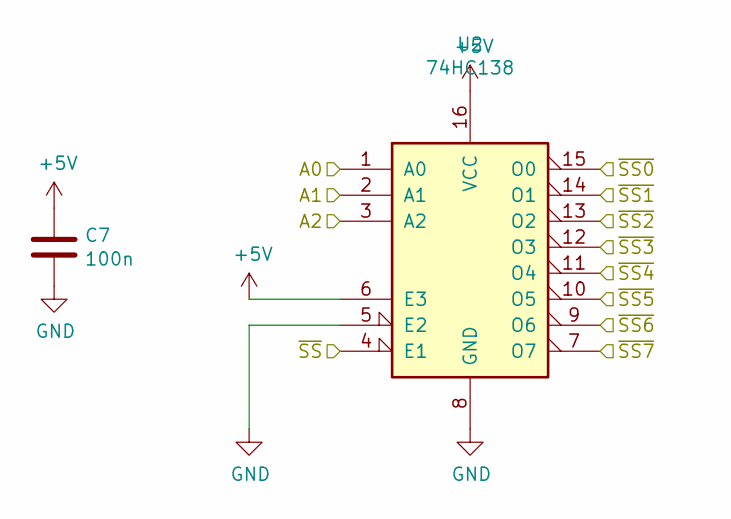
[picture p15: schematic LineMUX.sch, SS MUX]

Parts:
C7: 100n; C_Disc_D5.0mm_W2.5mm_P5.00mm
U2: 74HC138; DIP-16_W7.62mm

Connections:
+5V: C7.1, U2.6 (E3), U2.16 (VCC); also elsewhere on the board
/Controller/MUX0: U2.1 (A0); also elsewhere on the board
/Controller/MUX1: U2.2 (A1); also elsewhere on the board
/Controller/MUX2: U2.3 (A2); also elsewhere on the board
/Controller/~SS: U2.4 (E1); also elsewhere on the board
/Controller/~SS0: U2.15 (O0); also elsewhere on the board
/Controller/~SS1: U2.14 (O1); also elsewhere on the board
/Controller/~SS3: U2.12 (O3); also elsewhere on the board
/Controller/~SS4: U2.11 (O4); also elsewhere on the board
/Controller/~SS5: U2.10 (O5); also elsewhere on the board
/Controller/~SS6: U2.9 (O6); also elsewhere on the board
/Controller/~SS7: U2.7 (O7); also elsewhere on the board
/Controller/~SSDSP: U2.13 (O2); also elsewhere on the board
GND: C7.2, U2.5 (E2), U2.8 (GND); also elsewhere on the board

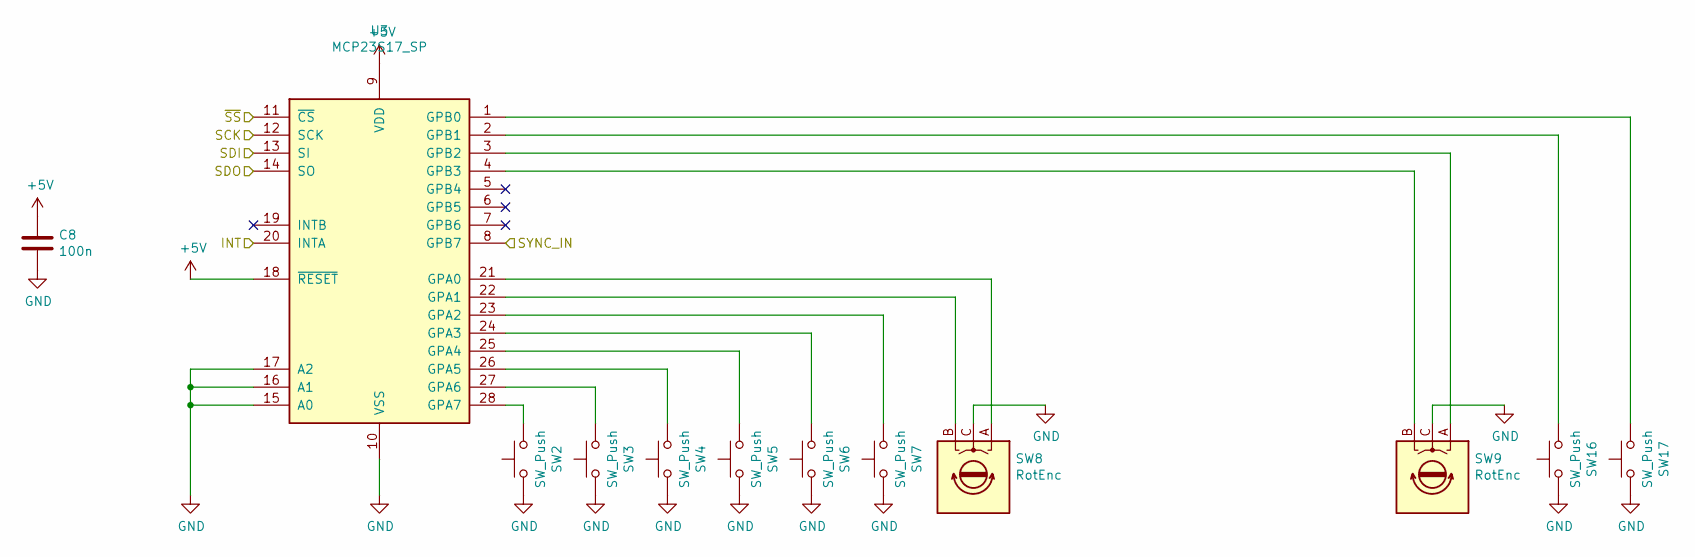
[picture p16: schematic Buttons.sch]

Parts:
C8: 100n; C_Disc_D5.0mm_W2.5mm_P5.00mm
SW2, SW3, SW4, SW5, SW6, SW7, SW16, SW17: SW_Push; SW_PUSH-12mm
SW8, SW9: RotEnc; RotaryEncoder_Alps_EC12E_Vertical_H20mm_CircularMountingHol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
U3: MCP23S17_SP; DIP-28_W7.62mm

Connections:
+5V: C8.1, U3.9 (VDD), U3.18 (~RESET~); also elsewhere on the board
/Controller/INT1: U3.20 (INTA); also elsewhere on the board
/Controller/SCK: U3.12 (SCK); also elsewhere on the board
/Controller/SDI: U3.14 (SO); also elsewhere on the board
/Controller/SDO: U3.13 (SI); also elsewhere on the board
/Controller/SYNC_IN: U3.8 (GPB7); also elsewhere on the board
/Controller/~SS1: U3.11 (~CS~); also elsewhere on the board
GND: C8.2, SW2.1, SW3.1, SW4.1, SW5.1, SW6.1, SW7.1, SW8.C, SW9.C, SW16.1, SW17.1, U3.10 (VSS), U3.15 (A0), U3.16 (A1), U3.17 (A2); also elsewhere on the board
unnamed: SW2.2, U3.28 (GPA7)
unnamed: SW3.2, U3.27 (GPA6)
unnamed: SW4.2, U3.26 (GPA5)
unnamed: SW5.2, U3.25 (GPA4)
unnamed: SW6.2, U3.24 (GPA3)
unnamed: SW7.2, U3.23 (GPA2)
unnamed: SW8.A, U3.21 (GPA0)
unnamed: SW8.B, U3.22 (GPA1)
unnamed: SW9.A, U3.3 (GPB2)
unnamed: SW9.B, U3.4 (GPB3)
unnamed: SW16.2, U3.2 (GPB1)
unnamed: SW17.2, U3.1 (GPB0)

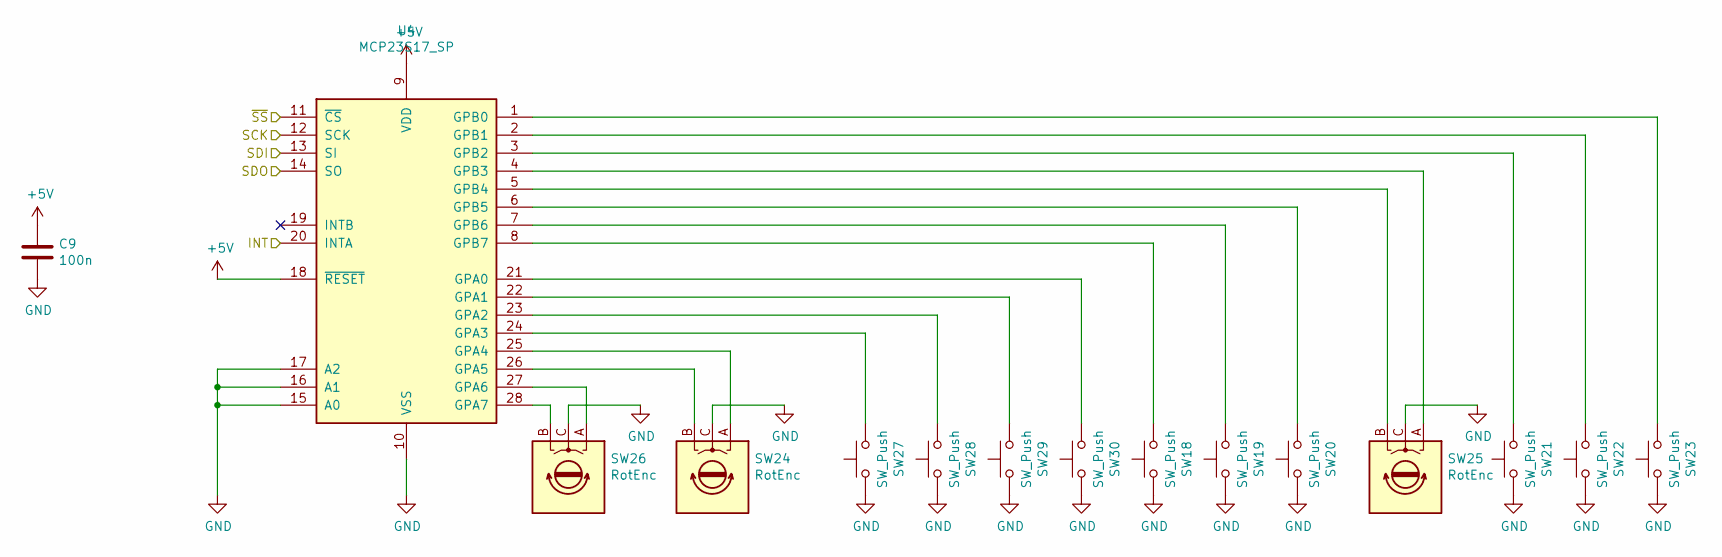
[picture p17: schematic ButtonsEncoders.sch, Buttons / Encoders]

Parts:
C9: 100n; C_Disc_D5.0mm_W2.5mm_P5.00mm
SW18, SW19, SW20, SW21, SW22, SW23, SW27, SW28, SW29, SW30: SW_Push; SW_PUSH-12mm
SW24, SW25, SW26: RotEnc; RotaryEncoder_Alps_EC12E_Vertical_H20mm_CircularMountingHol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
U4: MCP23S17_SP; DIP-28_W7.62mm

Connections:
+5V: C9.1, U4.9 (VDD), U4.18 (~RESET~); also elsewhere on the board
/Controller/INT0: U4.20 (INTA); also elsewhere on the board
/Controller/SCK: U4.12 (SCK); also elsewhere on the board
/Controller/SDI: U4.14 (SO); also elsewhere on the board
/Controller/SDO: U4.13 (SI); also elsewhere on the board
/Controller/~SS7: U4.11 (~CS~); also elsewhere on the board
GND: C9.2, SW18.1, SW19.1, SW20.1, SW21.1, SW22.1, SW23.1, SW24.C, SW25.C, SW26.C, SW27.1, SW28.1, SW29.1, SW30.1, U4.10 (VSS), U4.15 (A0), U4.16 (A1), U4.17 (A2); also elsewhere on the board
unnamed: SW18.2, U4.8 (GPB7)
unnamed: SW19.2, U4.7 (GPB6)
unnamed: SW20.2, U4.6 (GPB5)
unnamed: SW21.2, U4.3 (GPB2)
unnamed: SW22.2, U4.2 (GPB1)
unnamed: SW23.2, U4.1 (GPB0)
unnamed: SW24.A, U4.25 (GPA4)
unnamed: SW24.B, U4.26 (GPA5)
unnamed: SW25.A, U4.4 (GPB3)
unnamed: SW25.B, U4.5 (GPB4)
unnamed: SW26.A, U4.27 (GPA6)
unnamed: SW26.B, U4.28 (GPA7)
unnamed: SW27.2, U4.24 (GPA3)
unnamed: SW28.2, U4.23 (GPA2)
unnamed: SW29.2, U4.22 (GPA1)
unnamed: SW30.2, U4.21 (GPA0)

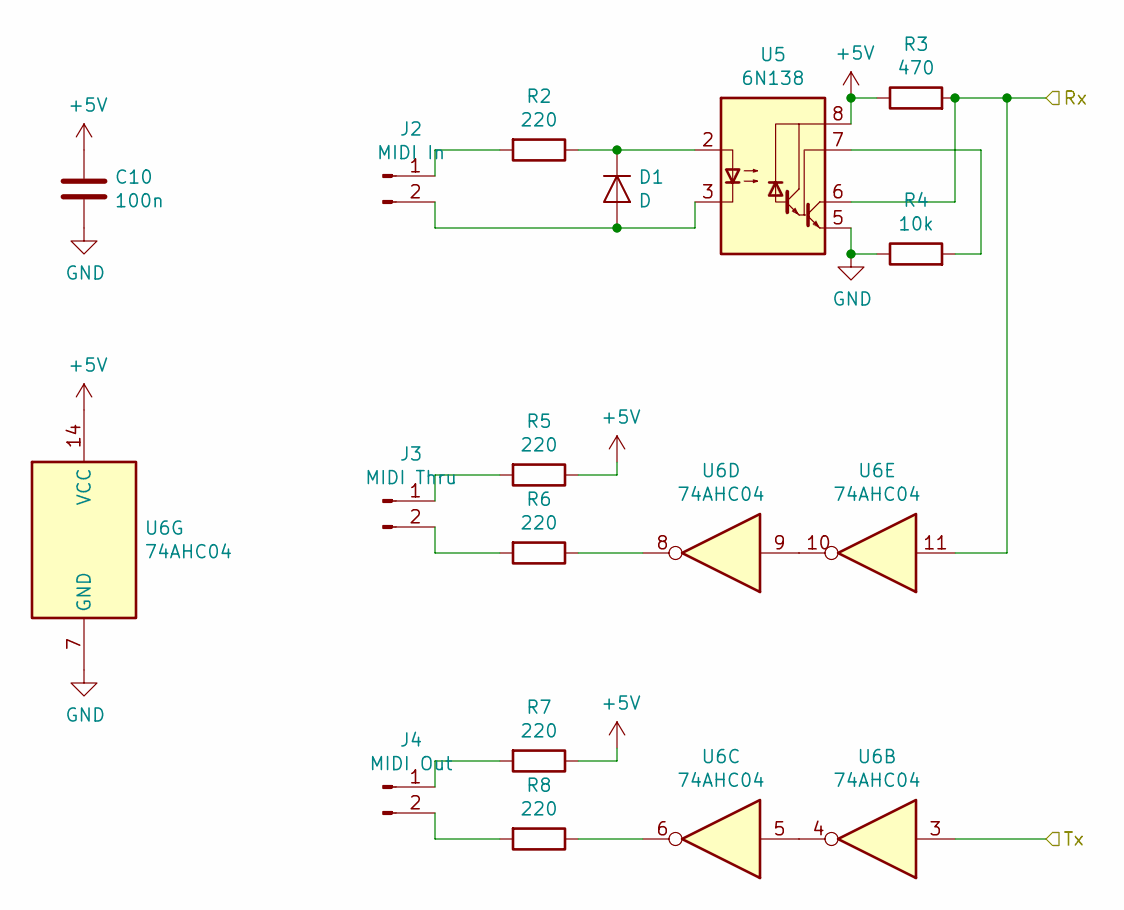
[picture p18: schematic MIDI.sch]

Parts:
C10: 100n; C_Disc_D5.0mm_W2.5mm_P5.00mm
D1: D; D_A-405_P10.16mm_Horizontal
J2: MIDI In; Molex_KK-254_AE-6410-02A_1x02_P2.54mm_Vertical
J3: MIDI Thru; Molex_KK-254_AE-6410-02A_1x02_P2.54mm_Vertical
J4: MIDI Out; Molex_KK-254_AE-6410-02A_1x02_P2.54mm_Vertical
R2, R5, R6, R7, R8: 220; R_Axial_DIN0207_L6.3mm_D2.5mm_P10.16mm_Horizontal
R3: 470; R_Axial_DIN0207_L6.3mm_D2.5mm_P10.16mm_Horizontal
R4: 10k; R_Axial_DIN0207_L6.3mm_D2.5mm_P10.16mm_Horizontal
U5: 6N138; DIP-8_W7.62mm
U6: 74AHC04; DIP-14_W7.62mm

Connections:
+5V: C10.1, R3.1, R5.1, R7.1, U5.8 (VCC), U6.14 (VCC); also elsewhere on the board
/Controller/Rx: R3.2, U5.6 (VO2), U6.11; also elsewhere on the board
/Controller/Tx: U6.3; also elsewhere on the board
GND: C10.2, R4.1, U5.5 (GND), U6.7 (GND); also elsewhere on the board
unnamed: D1.1 (K), R2.1, U5.2 (C1)
unnamed: D1.2 (A), J2.2, U5.3 (C2)
unnamed: J2.1, R2.2
unnamed: J3.1, R5.2
unnamed: J3.2, R6.2
unnamed: J4.1, R7.2
unnamed: J4.2, R8.2
unnamed: R4.2, U5.7 (VO1)
unnamed: R6.1, U6.8
unnamed: R8.1, U6.6
unnamed: U6.4, U6.5
unnamed: U6.9, U6.10

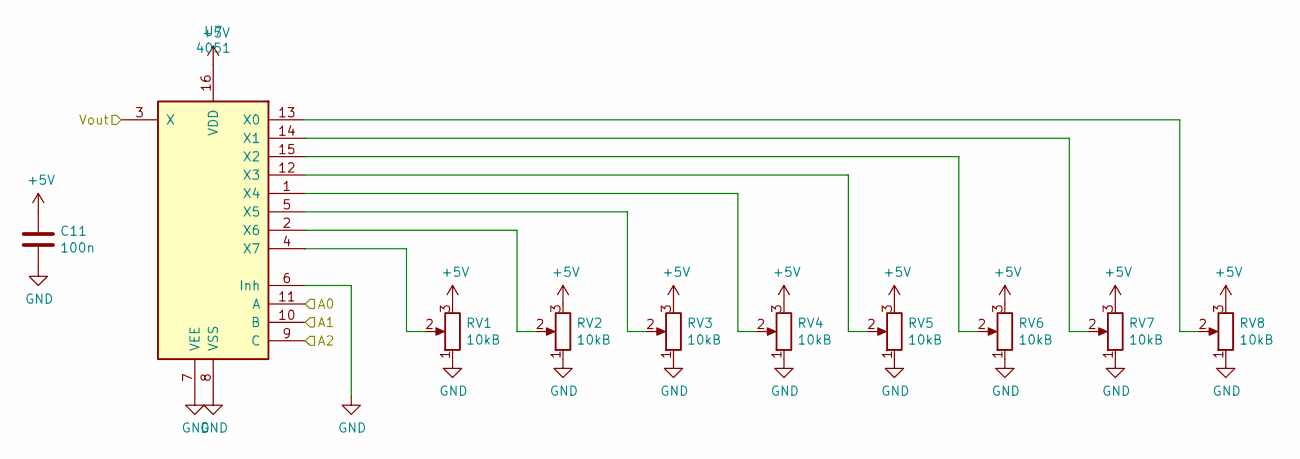
[picture p19: schematic Potentiometers1.sch, Potentiometers (1)]

Parts:
C11: 100n; C_Disc_D5.0mm_W2.5mm_P5.00mm
RV1, RV2, RV3, RV4, RV5, RV6, RV7, RV8: 10kB; Potentiometer_Alpha_RD901F-40-00D_Single_Vertical_CircularH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
U7: 4051; DIP-16_W7.62mm

Connections:
+5V: C11.1, RV1.3, RV2.3, RV3.3, RV4.3, RV5.3, RV6.3, RV7.3, RV8.3, U7.16 (VDD); also elsewhere on the board
/Controller/AN2: U7.3 (X); also elsewhere on the board
/Controller/MUX0: U7.11 (A); also elsewhere on the board
/Controller/MUX1: U7.10 (B); also elsewhere on the board
/Controller/MUX2: U7.9 (C); also elsewhere on the board
GND: C11.2, RV1.1, RV2.1, RV3.1, RV4.1, RV5.1, RV6.1, RV7.1, RV8.1, U7.6 (Inh), U7.7 (VEE), U7.8 (VSS); also elsewhere on the board
unnamed: RV1.2, U7.4 (X7)
unnamed: RV2.2, U7.2 (X6)
unnamed: RV3.2, U7.5 (X5)
unnamed: RV4.2, U7.1 (X4)
unnamed: RV5.2, U7.12 (X3)
unnamed: RV6.2, U7.15 (X2)
unnamed: RV7.2, U7.14 (X1)
unnamed: RV8.2, U7.13 (X0)

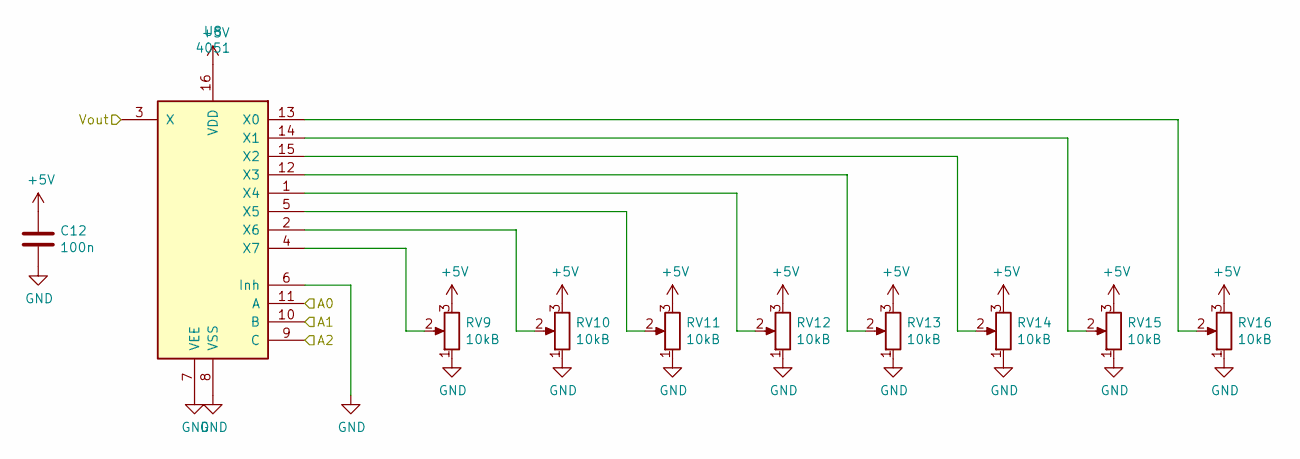
[picture p20: schematic Potentiometers2.sch, Potentiometers (1)]

Parts:
C12: 100n; C_Disc_D5.0mm_W2.5mm_P5.00mm
RV9, RV10, RV11, RV12, RV13, RV14, RV15, RV16: 10kB; Potentiometer_Alpha_RD901F-40-00D_Single_Vertical_CircularH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
U8: 4051; DIP-16_W7.62mm

Connections:
+5V: C12.1, RV9.3, RV10.3, RV11.3, RV12.3, RV13.3, RV14.3, RV15.3, RV16.3, U8.16 (VDD); also elsewhere on the board
/Controller/AN0: U8.3 (X); also elsewhere on the board
/Controller/MUX0: U8.11 (A); also elsewhere on the board
/Controller/MUX1: U8.10 (B); also elsewhere on the board
/Controller/MUX2: U8.9 (C); also elsewhere on the board
GND: C12.2, RV9.1, RV10.1, RV11.1, RV12.1, RV13.1, RV14.1, RV15.1, RV16.1, U8.6 (Inh), U8.7 (VEE), U8.8 (VSS); also elsewhere on the board
unnamed: RV9.2, U8.4 (X7)
unnamed: RV10.2, U8.2 (X6)
unnamed: RV11.2, U8.5 (X5)
unnamed: RV12.2, U8.1 (X4)
unnamed: RV13.2, U8.12 (X3)
unnamed: RV14.2, U8.15 (X2)
unnamed: RV15.2, U8.14 (X1)
unnamed: RV16.2, U8.13 (X0)

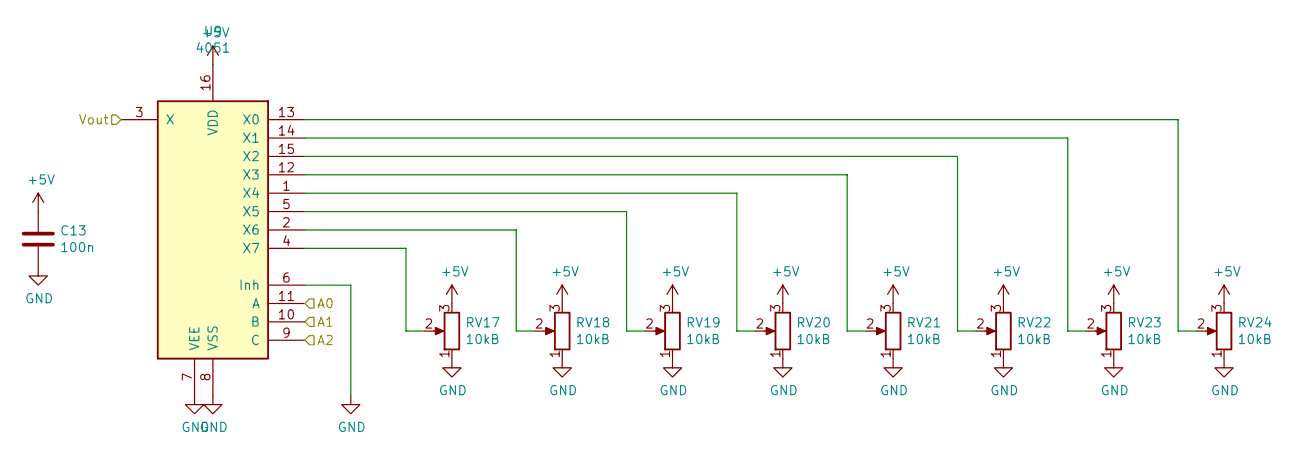
[picture p21: schematic Potentiometers3.sch, Potentiometers (1)]

Parts:
C13: 100n; C_Disc_D5.0mm_W2.5mm_P5.00mm
RV17, RV18, RV19, RV20, RV21, RV22, RV23, RV24: 10kB; Potentiometer_Alpha_RD901F-40-00D_Single_Vertical_CircularH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
U9: 4051; DIP-16_W7.62mm

Connections:
+5V: C13.1, RV17.3, RV18.3, RV19.3, RV20.3, RV21.3, RV22.3, RV23.3, RV24.3, U9.16 (VDD); also elsewhere on the board
/Controller/AN4: U9.3 (X); also elsewhere on the board
/Controller/MUX0: U9.11 (A); also elsewhere on the board
/Controller/MUX1: U9.10 (B); also elsewhere on the board
/Controller/MUX2: U9.9 (C); also elsewhere on the board
GND: C13.2, RV17.1, RV18.1, RV19.1, RV20.1, RV21.1, RV22.1, RV23.1, RV24.1, U9.6 (Inh), U9.7 (VEE), U9.8 (VSS); also elsewhere on the board
unnamed: RV17.2, U9.4 (X7)
unnamed: RV18.2, U9.2 (X6)
unnamed: RV19.2, U9.5 (X5)
unnamed: RV20.2, U9.1 (X4)
unnamed: RV21.2, U9.12 (X3)
unnamed: RV22.2, U9.15 (X2)
unnamed: RV23.2, U9.14 (X1)
unnamed: RV24.2, U9.13 (X0)

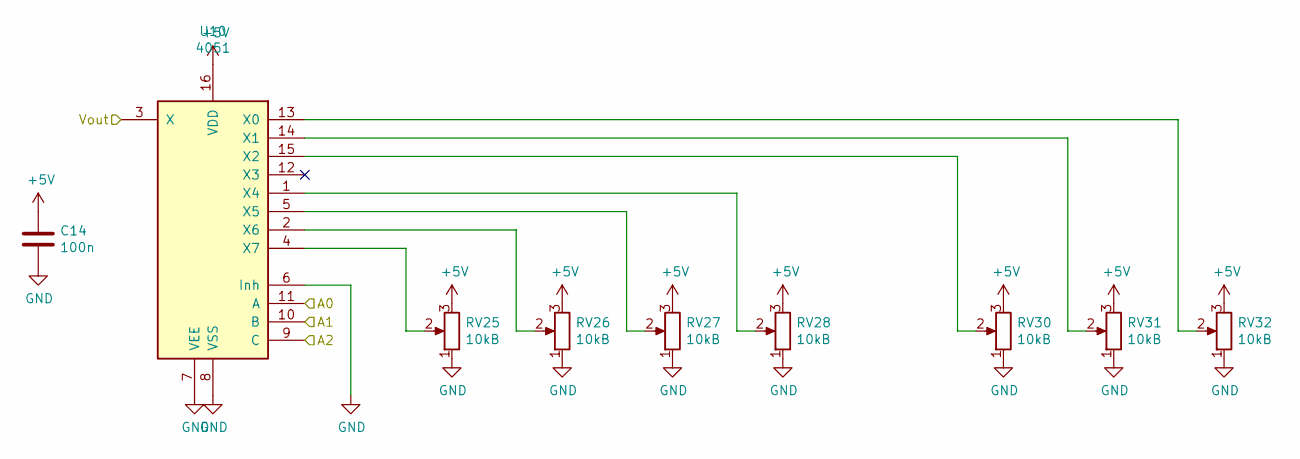
[picture p22: schematic Potentiometers4.sch, Potentiometers (1)]

Parts:
C14: 100n; C_Disc_D5.0mm_W2.5mm_P5.00mm
RV25, RV26, RV27, RV28, RV30, RV31, RV32: 10kB; Potentiometer_Alpha_RD901F-40-00D_Single_Vertical_CircularH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
U10: 4051; DIP-16_W7.62mm

Connections:
+5V: C14.1, RV25.3, RV26.3, RV27.3, RV28.3, RV30.3, RV31.3, RV32.3, U10.16 (VDD); also elsewhere on the board
/Controller/AN3: U10.3 (X); also elsewhere on the board
/Controller/MUX0: U10.11 (A); also elsewhere on the board
/Controller/MUX1: U10.10 (B); also elsewhere on the board
/Controller/MUX2: U10.9 (C); also elsewhere on the board
GND: C14.2, RV25.1, RV26.1, RV27.1, RV28.1, RV30.1, RV31.1, RV32.1, U10.6 (Inh), U10.7 (VEE), U10.8 (VSS); also elsewhere on the board
unnamed: RV25.2, U10.4 (X7)
unnamed: RV26.2, U10.2 (X6)
unnamed: RV27.2, U10.5 (X5)
unnamed: RV28.2, U10.1 (X4)
unnamed: RV30.2, U10.15 (X2)
unnamed: RV31.2, U10.14 (X1)
unnamed: RV32.2, U10.13 (X0)

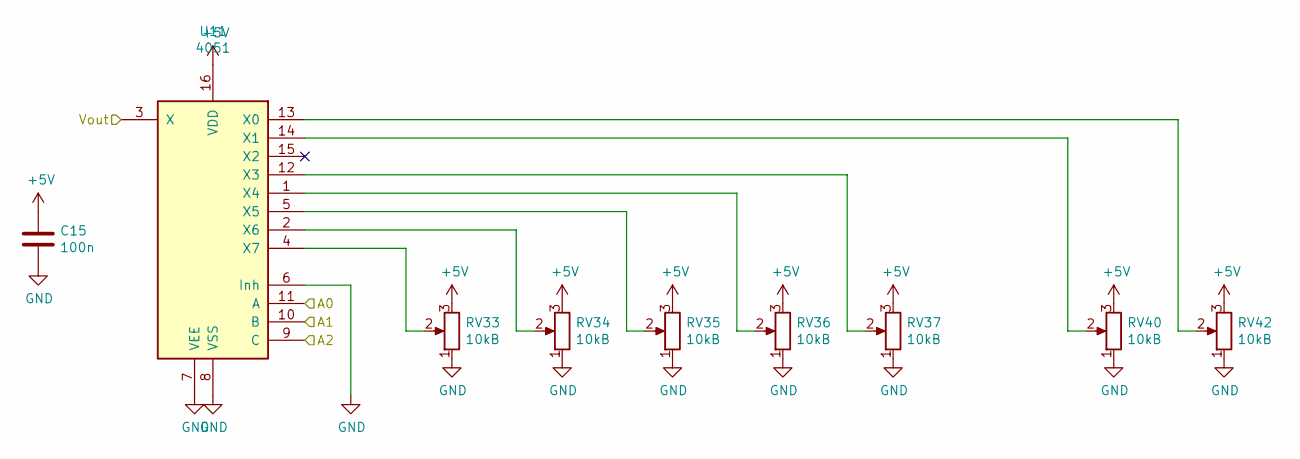
[picture p23: schematic Potentiometers5.sch, Potentiometers (1)]

Parts:
C15: 100n; C_Disc_D5.0mm_W2.5mm_P5.00mm
RV33, RV34, RV35, RV36, RV37, RV40, RV42: 10kB; Potentiometer_Alpha_RD901F-40-00D_Single_Vertical_CircularH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
U11: 4051; DIP-16_W7.62mm

Connections:
+5V: C15.1, RV33.3, RV34.3, RV35.3, RV36.3, RV37.3, RV40.3, RV42.3, U11.16 (VDD); also elsewhere on the board
/Controller/AN1: U11.3 (X); also elsewhere on the board
/Controller/MUX0: U11.11 (A); also elsewhere on the board
/Controller/MUX1: U11.10 (B); also elsewhere on the board
/Controller/MUX2: U11.9 (C); also elsewhere on the board
GND: C15.2, RV33.1, RV34.1, RV35.1, RV36.1, RV37.1, RV40.1, RV42.1, U11.6 (Inh), U11.7 (VEE), U11.8 (VSS); also elsewhere on the board
unnamed: RV33.2, U11.4 (X7)
unnamed: RV34.2, U11.2 (X6)
unnamed: RV35.2, U11.5 (X5)
unnamed: RV36.2, U11.1 (X4)
unnamed: RV37.2, U11.12 (X3)
unnamed: RV40.2, U11.14 (X1)
unnamed: RV42.2, U11.13 (X0)

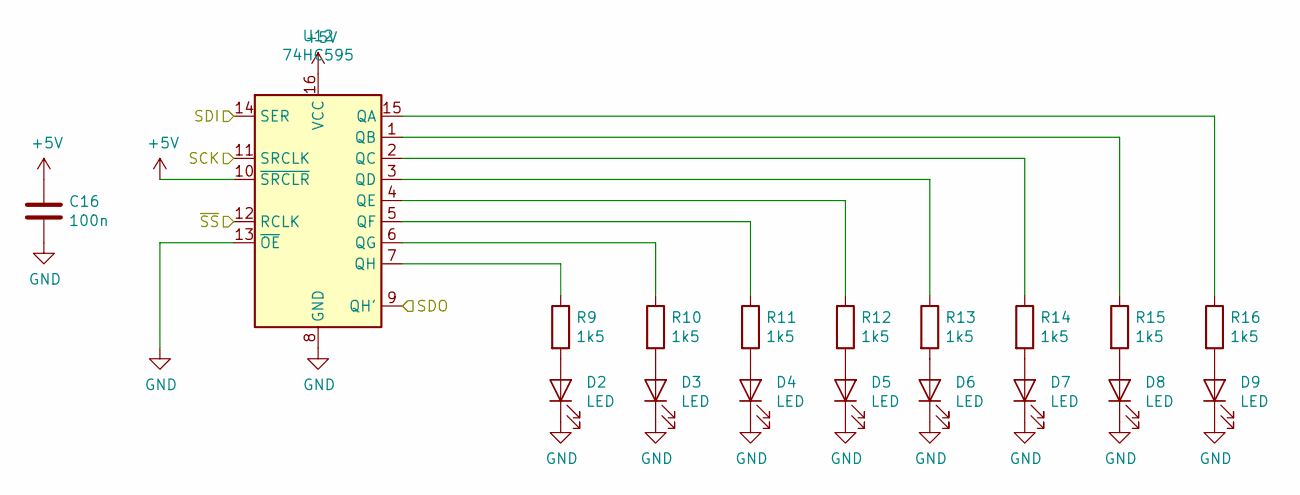
[picture p24: schematic LED1.sch, LED (1)]

Parts:
C16: 100n; C_Disc_D5.0mm_W2.5mm_P5.00mm
D2, D3, D4, D5, D6, D7, D8, D9: LED; LED_D3.0mm
R9, R10, R11, R12, R13, R14, R15, R16: 1k5; R_Axial_DIN0207_L6.3mm_D2.5mm_P10.16mm_Horizontal
U12: 74HC595; DIP-16_W7.62mm

Connections:
+5V: C16.1, U12.10 (~SRCLR), U12.16 (VCC); also elsewhere on the board
/Controller/LED (1)/SDI: U12.14 (SER); also elsewhere on the board
/Controller/LED (3)/SDI: U12.9 (QH'); also elsewhere on the board
/Controller/SCK: U12.11 (SRCLK); also elsewhere on the board
/Controller/~SS0: U12.12 (RCLK); also elsewhere on the board
GND: C16.2, D2.1 (K), D3.1 (K), D4.1 (K), D5.1 (K), D6.1 (K), D7.1 (K), D8.1 (K), D9.1 (K), U12.8 (GND), U12.13 (~OE); also elsewhere on the board
unnamed: D2.2 (A), R9.2
unnamed: D3.2 (A), R10.2
unnamed: D4.2 (A), R11.2
unnamed: D5.2 (A), R12.2
unnamed: D6.2 (A), R13.2
unnamed: D7.2 (A), R14.2
unnamed: D8.2 (A), R15.2
unnamed: D9.2 (A), R16.2
unnamed: R9.1, U12.7 (QH)
unnamed: R10.1, U12.6 (QG)
unnamed: R11.1, U12.5 (QF)
unnamed: R12.1, U12.4 (QE)
unnamed: R13.1, U12.3 (QD)
unnamed: R14.1, U12.2 (QC)
unnamed: R15.1, U12.1 (QB)
unnamed: R16.1, U12.15 (QA)

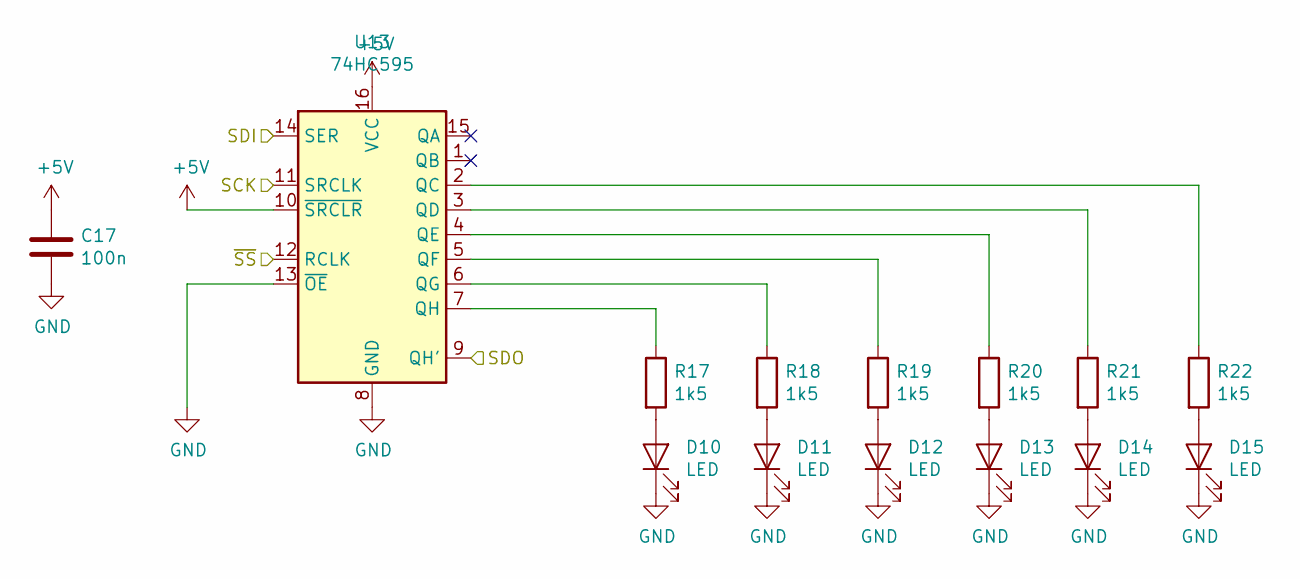
[picture p25: schematic LED2.sch, LED (1)]

Parts:
C17: 100n; C_Disc_D5.0mm_W2.5mm_P5.00mm
D10, D11, D12, D13, D14, D15: LED; LED_D3.0mm
R17, R18, R19, R20, R21, R22: 1k5; R_Axial_DIN0207_L6.3mm_D2.5mm_P10.16mm_Horizontal
U13: 74HC595; DIP-16_W7.62mm

Connections:
+5V: C17.1, U13.10 (~SRCLR), U13.16 (VCC); also elsewhere on the board
/Controller/LED (1)/SDI: U13.9 (QH'); also elsewhere on the board
/Controller/LED (2)/SDI: U13.14 (SER); also elsewhere on the board
/Controller/SCK: U13.11 (SRCLK); also elsewhere on the board
/Controller/~SS0: U13.12 (RCLK); also elsewhere on the board
GND: C17.2, D10.1 (K), D11.1 (K), D12.1 (K), D13.1 (K), D14.1 (K), D15.1 (K), U13.8 (GND), U13.13 (~OE); also elsewhere on the board
unnamed: D10.2 (A), R17.2
unnamed: D11.2 (A), R18.2
unnamed: D12.2 (A), R19.2
unnamed: D13.2 (A), R20.2
unnamed: D14.2 (A), R21.2
unnamed: D15.2 (A), R22.2
unnamed: R17.1, U13.7 (QH)
unnamed: R18.1, U13.6 (QG)
unnamed: R19.1, U13.5 (QF)
unnamed: R20.1, U13.4 (QE)
unnamed: R21.1, U13.3 (QD)
unnamed: R22.1, U13.2 (QC)

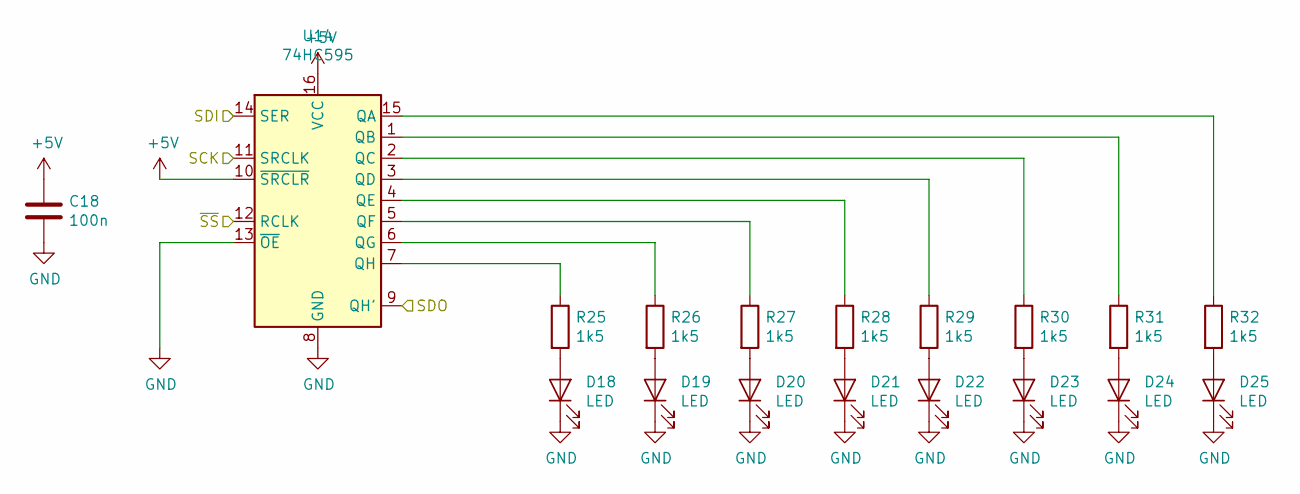
[picture p26: schematic LED3.sch, LED (1)]

Parts:
C18: 100n; C_Disc_D5.0mm_W2.5mm_P5.00mm
D18, D19, D20, D21, D22, D23, D24, D25: LED; LED_D3.0mm
R25, R26, R27, R28, R29, R30, R31, R32: 1k5; R_Axial_DIN0207_L6.3mm_D2.5mm_P10.16mm_Horizontal
U14: 74HC595; DIP-16_W7.62mm

Connections:
+5V: C18.1, U14.10 (~SRCLR), U14.16 (VCC); also elsewhere on the board
/Controller/LED (3)/SDI: U14.14 (SER); also elsewhere on the board
/Controller/SCK: U14.11 (SRCLK); also elsewhere on the board
/Controller/~SS0: U14.12 (RCLK); also elsewhere on the board
GND: C18.2, D18.1 (K), D19.1 (K), D20.1 (K), D21.1 (K), D22.1 (K), D23.1 (K), D24.1 (K), D25.1 (K), U14.8 (GND), U14.13 (~OE); also elsewhere on the board
unnamed: D18.2 (A), R25.2
unnamed: D19.2 (A), R26.2
unnamed: D20.2 (A), R27.2
unnamed: D21.2 (A), R28.2
unnamed: D22.2 (A), R29.2
unnamed: D23.2 (A), R30.2
unnamed: D24.2 (A), R31.2
unnamed: D25.2 (A), R32.2
unnamed: R25.1, U14.7 (QH)
unnamed: R26.1, U14.6 (QG)
unnamed: R27.1, U14.5 (QF)
unnamed: R28.1, U14.4 (QE)
unnamed: R29.1, U14.3 (QD)
unnamed: R30.1, U14.2 (QC)
unnamed: R31.1, U14.1 (QB)
unnamed: R32.1, U14.15 (QA)

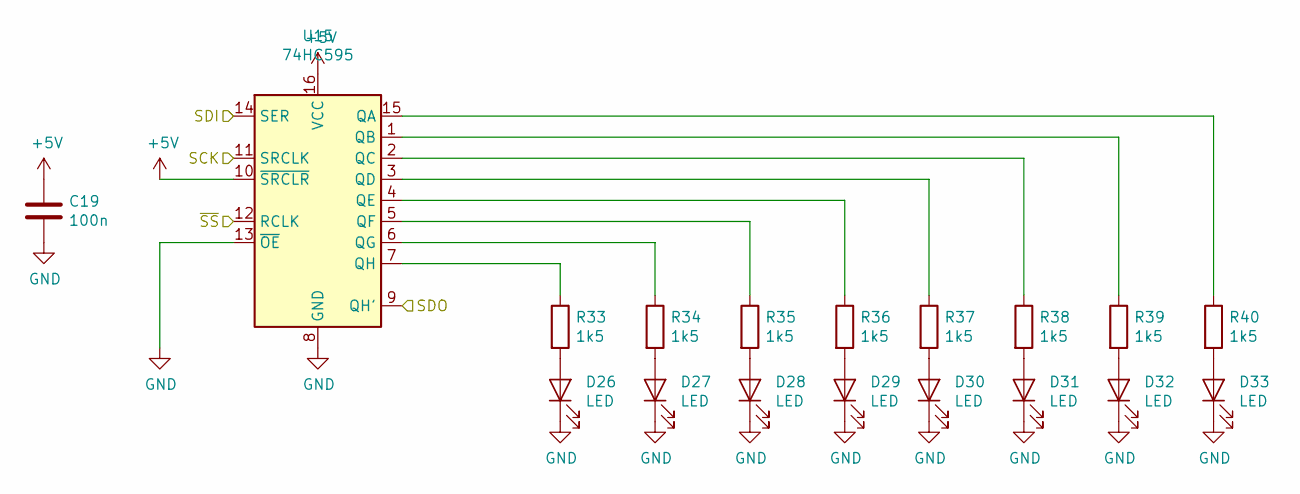
[picture p27: schematic LED4.sch, LED (1)]

Parts:
C19: 100n; C_Disc_D5.0mm_W2.5mm_P5.00mm
D26, D27, D28, D29, D30, D31, D32, D33: LED; LED_D3.0mm
R33, R34, R35, R36, R37, R38, R39, R40: 1k5; R_Axial_DIN0207_L6.3mm_D2.5mm_P10.16mm_Horizontal
U15: 74HC595; DIP-16_W7.62mm

Connections:
+5V: C19.1, U15.10 (~SRCLR), U15.16 (VCC); also elsewhere on the board
/Controller/LED (2)/SDI: U15.9 (QH'); also elsewhere on the board
/Controller/LED (4)/SDI: U15.14 (SER); also elsewhere on the board
/Controller/SCK: U15.11 (SRCLK); also elsewhere on the board
/Controller/~SS0: U15.12 (RCLK); also elsewhere on the board
GND: C19.2, D26.1 (K), D27.1 (K), D28.1 (K), D29.1 (K), D30.1 (K), D31.1 (K), D32.1 (K), D33.1 (K), U15.8 (GND), U15.13 (~OE); also elsewhere on the board
unnamed: D26.2 (A), R33.2
unnamed: D27.2 (A), R34.2
unnamed: D28.2 (A), R35.2
unnamed: D29.2 (A), R36.2
unnamed: D30.2 (A), R37.2
unnamed: D31.2 (A), R38.2
unnamed: D32.2 (A), R39.2
unnamed: D33.2 (A), R40.2
unnamed: R33.1, U15.7 (QH)
unnamed: R34.1, U15.6 (QG)
unnamed: R35.1, U15.5 (QF)
unnamed: R36.1, U15.4 (QE)
unnamed: R37.1, U15.3 (QD)
unnamed: R38.1, U15.2 (QC)
unnamed: R39.1, U15.1 (QB)
unnamed: R40.1, U15.15 (QA)

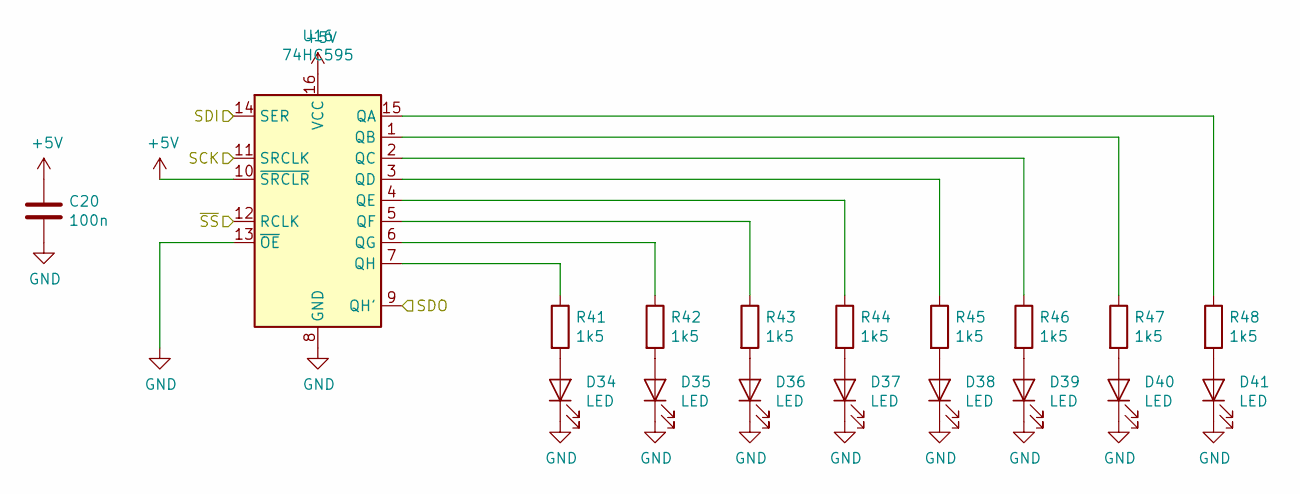
[picture p28: schematic LED5.sch, LED (1)]

Parts:
C20: 100n; C_Disc_D5.0mm_W2.5mm_P5.00mm
D34, D35, D36, D37, D38, D39, D40, D41: LED; LED_D3.0mm
R41, R42, R43, R44, R45, R46, R47, R48: 1k5; R_Axial_DIN0207_L6.3mm_D2.5mm_P10.16mm_Horizontal
U16: 74HC595; DIP-16_W7.62mm

Connections:
+5V: C20.1, U16.10 (~SRCLR), U16.16 (VCC); also elsewhere on the board
/Controller/LED (4)/SDI: U16.9 (QH'); also elsewhere on the board
/Controller/LED (5)/SDI: U16.14 (SER); also elsewhere on the board
/Controller/SCK: U16.11 (SRCLK); also elsewhere on the board
/Controller/~SS0: U16.12 (RCLK); also elsewhere on the board
GND: C20.2, D34.1 (K), D35.1 (K), D36.1 (K), D37.1 (K), D38.1 (K), D39.1 (K), D40.1 (K), D41.1 (K), U16.8 (GND), U16.13 (~OE); also elsewhere on the board
unnamed: D34.2 (A), R41.2
unnamed: D35.2 (A), R42.2
unnamed: D36.2 (A), R43.2
unnamed: D37.2 (A), R44.2
unnamed: D38.2 (A), R45.2
unnamed: D39.2 (A), R46.2
unnamed: D40.2 (A), R47.2
unnamed: D41.2 (A), R48.2
unnamed: R41.1, U16.7 (QH)
unnamed: R42.1, U16.6 (QG)
unnamed: R43.1, U16.5 (QF)
unnamed: R44.1, U16.4 (QE)
unnamed: R45.1, U16.3 (QD)
unnamed: R46.1, U16.2 (QC)
unnamed: R47.1, U16.1 (QB)
unnamed: R48.1, U16.15 (QA)

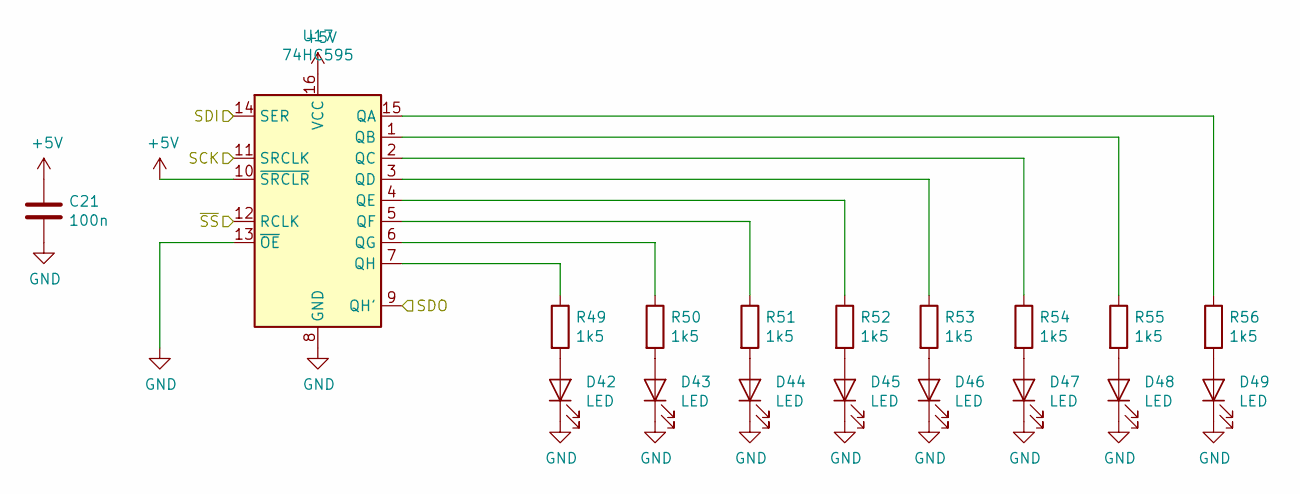
[picture p29: schematic LED6.sch, LED (1)]

Parts:
C21: 100n; C_Disc_D5.0mm_W2.5mm_P5.00mm
D42, D43, D44, D45, D46, D47, D48, D49: LED; LED_D3.0mm
R49, R50, R51, R52, R53, R54, R55, R56: 1k5; R_Axial_DIN0207_L6.3mm_D2.5mm_P10.16mm_Horizontal
U17: 74HC595; DIP-16_W7.62mm

Connections:
+5V: C21.1, U17.10 (~SRCLR), U17.16 (VCC); also elsewhere on the board
/Controller/LED (5)/SDI: U17.9 (QH'); also elsewhere on the board
/Controller/SCK: U17.11 (SRCLK); also elsewhere on the board
/Controller/SDO: U17.14 (SER); also elsewhere on the board
/Controller/~SS0: U17.12 (RCLK); also elsewhere on the board
GND: C21.2, D42.1 (K), D43.1 (K), D44.1 (K), D45.1 (K), D46.1 (K), D47.1 (K), D48.1 (K), D49.1 (K), U17.8 (GND), U17.13 (~OE); also elsewhere on the board
unnamed: D42.2 (A), R49.2
unnamed: D43.2 (A), R50.2
unnamed: D44.2 (A), R51.2
unnamed: D45.2 (A), R52.2
unnamed: D46.2 (A), R53.2
unnamed: D47.2 (A), R54.2
unnamed: D48.2 (A), R55.2
unnamed: D49.2 (A), R56.2
unnamed: R49.1, U17.7 (QH)
unnamed: R50.1, U17.6 (QG)
unnamed: R51.1, U17.5 (QF)
unnamed: R52.1, U17.4 (QE)
unnamed: R53.1, U17.3 (QD)
unnamed: R54.1, U17.2 (QC)
unnamed: R55.1, U17.1 (QB)
unnamed: R56.1, U17.15 (QA)
