andreaslagler/giove8k/hw/ControlBoard/ControlBoard.kicad_pcb

## KiCad design hw/ControlBoard/ControlBoard.kicad_pcb (continued)

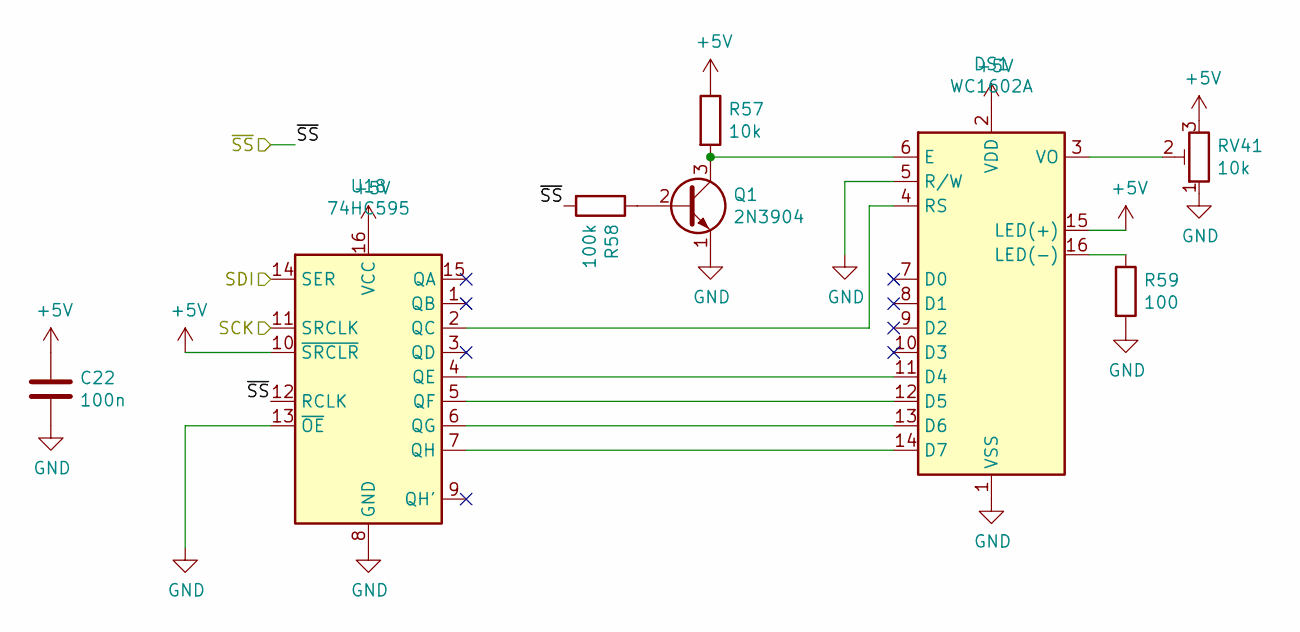
[picture p30: schematic LCD.sch]

Parts:
C22: 100n; C_Disc_D5.0mm_W2.5mm_P5.00mm
DS1: WC1602A
Q1: 2N3904; TO-92
R57: 10k; R_Axial_DIN0207_L6.3mm_D2.5mm_P10.16mm_Horizontal
R58: 100k; R_Axial_DIN0207_L6.3mm_D2.5mm_P10.16mm_Horizontal
R59: 100; R_Axial_DIN0207_L6.3mm_D2.5mm_P10.16mm_Horizontal
RV41: 10k; Potentiometer_Piher_PT-6-V_Vertical
U18: 74HC595; DIP-16_W7.62mm

Connections:
+5V: C22.1, DS1.2 (VDD), DS1.15 (LED(+)), R57.1, RV41.3, U18.10 (~SRCLR), U18.16 (VCC); also elsewhere on the board
/Controller/SCK: U18.11 (SRCLK); also elsewhere on the board
/Controller/SDO: U18.14 (SER); also elsewhere on the board
/Controller/~SS3: R58.2, U18.12 (RCLK); also elsewhere on the board
GND: C22.2, DS1.1 (VSS), DS1.5 (R/W), Q1.1 (E), R59.2, RV41.1, U18.8 (GND), U18.13 (~OE); also elsewhere on the board
unnamed: DS1.3 (VO), RV41.2
unnamed: DS1.4 (RS), U18.2 (QC)
unnamed: DS1.6 (E), Q1.3 (C), R57.2
unnamed: DS1.11 (D4), U18.4 (QE)
unnamed: DS1.12 (D5), U18.5 (QF)
unnamed: DS1.13 (D6), U18.6 (QG)
unnamed: DS1.14 (D7), U18.7 (QH)
unnamed: DS1.16 (LED(-)), R59.1
unnamed: Q1.2 (B), R58.1

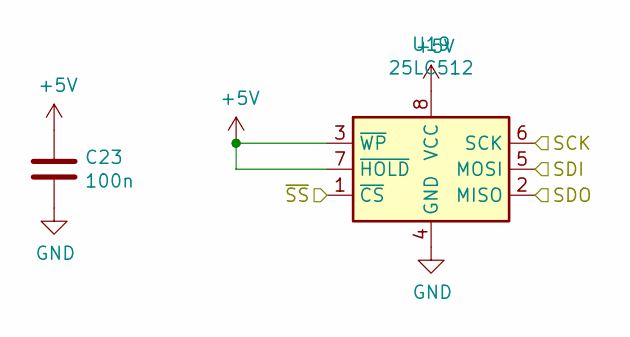
[picture p31: schematic EEPROM1.sch, EEPROM]

Parts:
C23: 100n; C_Disc_D5.0mm_W2.5mm_P5.00mm
U19: 25LC512; DIP-8_W7.62mm

Connections:
+5V: C23.1, U19.3 (~WP), U19.7 (~HOLD), U19.8 (VCC); also elsewhere on the board
/Controller/SCK: U19.6 (SCK); also elsewhere on the board
/Controller/SDI: U19.2 (MISO); also elsewhere on the board
/Controller/SDO: U19.5 (MOSI); also elsewhere on the board
/Controller/~SS4: U19.1 (~CS); also elsewhere on the board
GND: C23.2, U19.4 (GND); also elsewhere on the board

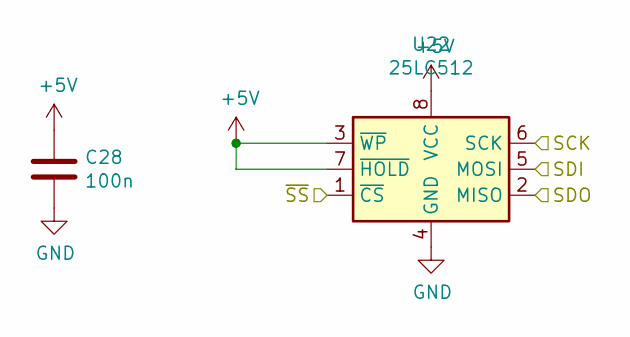
[picture p32: schematic EEPROM2.sch, EEPROM]

Parts:
C28: 100n; C_Disc_D5.0mm_W2.5mm_P5.00mm
U22: 25LC512; DIP-8_W7.62mm

Connections:
+5V: C28.1, U22.3 (~WP), U22.7 (~HOLD), U22.8 (VCC); also elsewhere on the board
/Controller/SCK: U22.6 (SCK); also elsewhere on the board
/Controller/SDI: U22.2 (MISO); also elsewhere on the board
/Controller/SDO: U22.5 (MOSI); also elsewhere on the board
/Controller/~SS5: U22.1 (~CS); also elsewhere on the board
GND: C28.2, U22.4 (GND); also elsewhere on the board

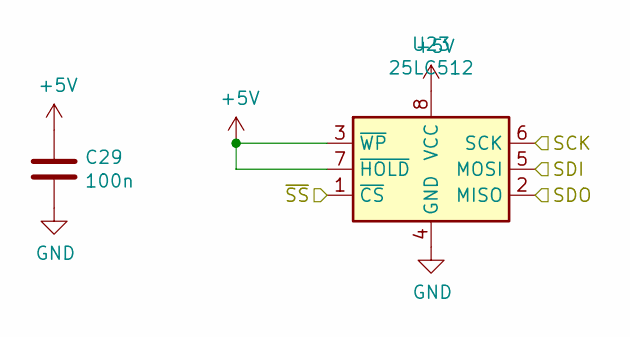
[picture p33: schematic EEPROM3.sch, EEPROM]

Parts:
C29: 100n; C_Disc_D5.0mm_W2.5mm_P5.00mm
U23: 25LC512; DIP-8_W7.62mm

Connections:
+5V: C29.1, U23.3 (~WP), U23.7 (~HOLD), U23.8 (VCC); also elsewhere on the board
/Controller/SCK: U23.6 (SCK); also elsewhere on the board
/Controller/SDI: U23.2 (MISO); also elsewhere on the board
/Controller/SDO: U23.5 (MOSI); also elsewhere on the board
/Controller/~SS6: U23.1 (~CS); also elsewhere on the board
GND: C29.2, U23.4 (GND); also elsewhere on the board

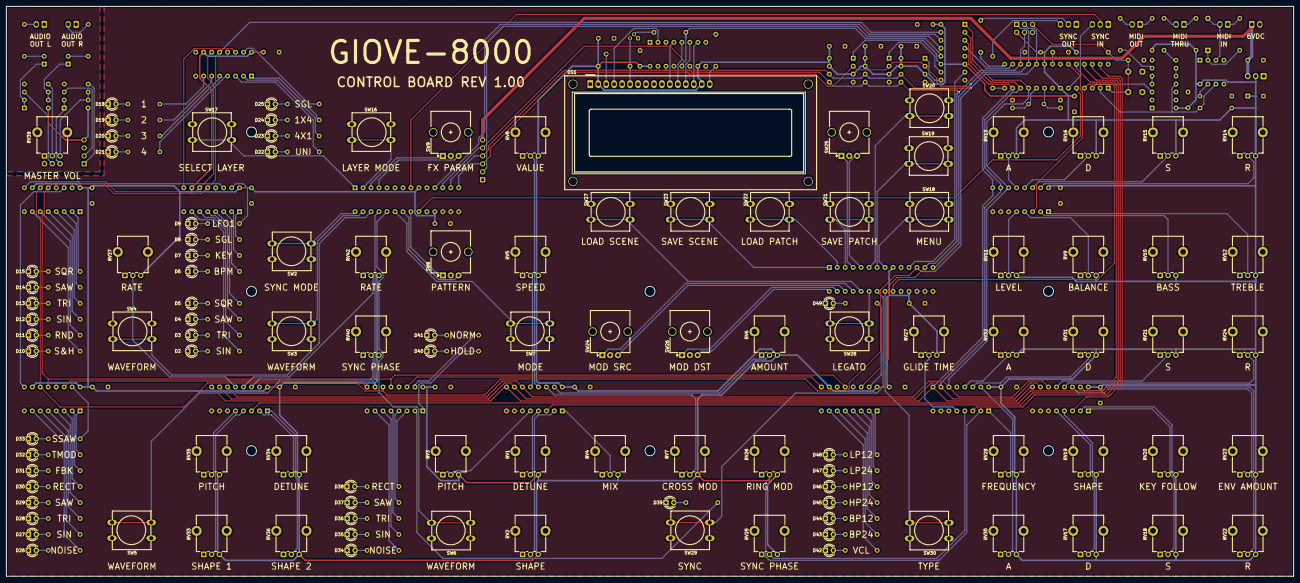
[picture p34: board ControlBoard.kicad_pcb from above]

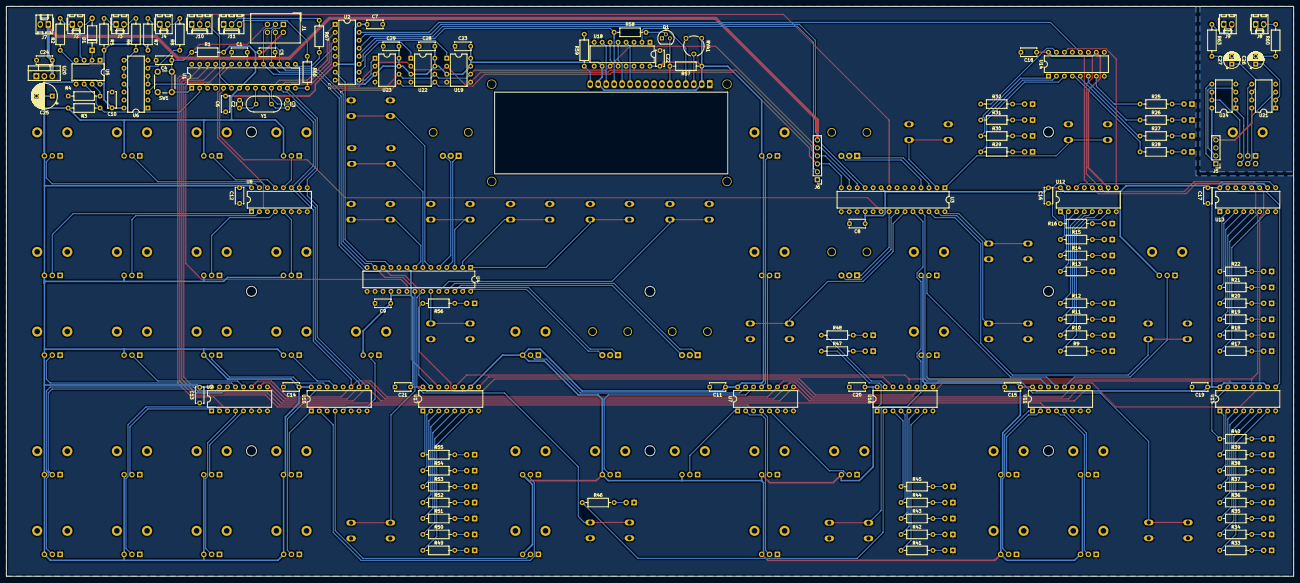
[picture p35: board ControlBoard.kicad_pcb from below]

Board: 2 copper layers, 410.2 x 181.6 mm, 239 parts (130 on the bottom side), 235 nets.

Other parts of the board:
J7: 6VDC; Molex_KK-254_AE-6410-02A_1x02_P2.54mm_Vertical

Their connections:
+6V: J7.1; also elsewhere on the board
GND: J7.2; also elsewhere on the board
